cenekSvoboda/14000JKFF/1.0.X_CHYBA.jpg

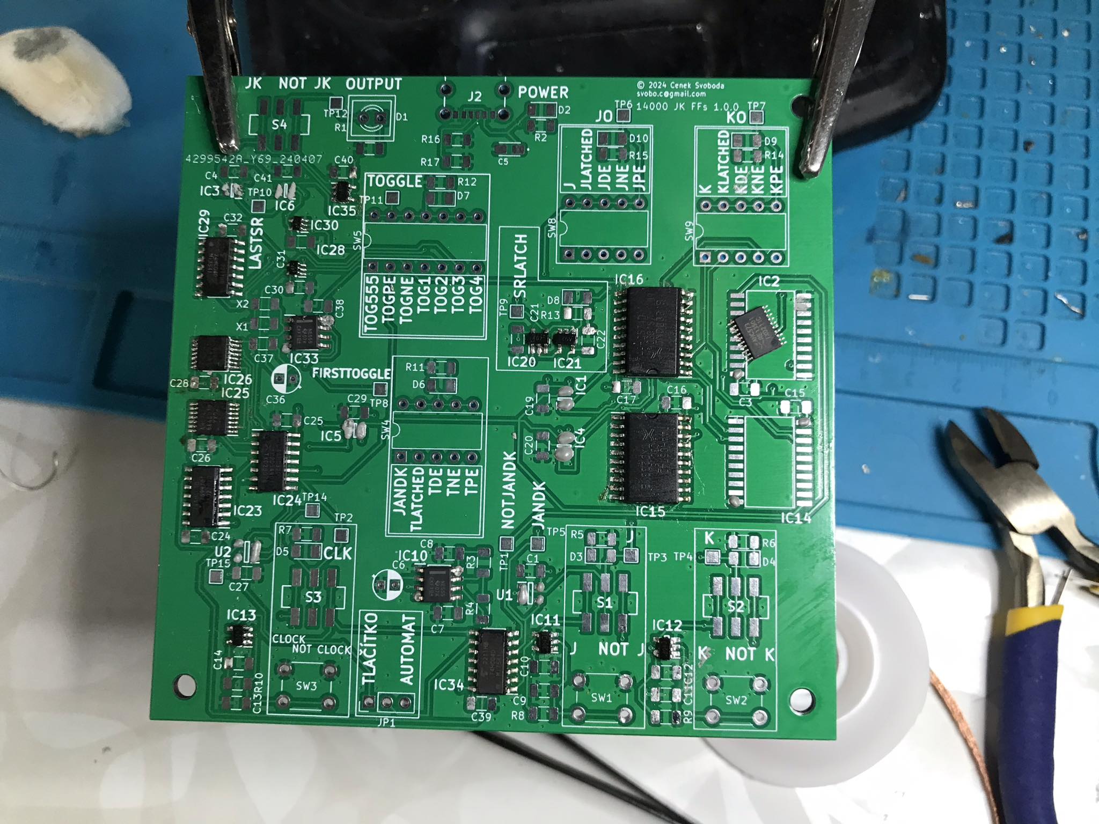
1.0.X_CHYBA.jpg
