cenekSvoboda/14000JKFF/promo1.1.0/7dd303d3-2326-45fb-b104-9f73cf640fcb.jpg

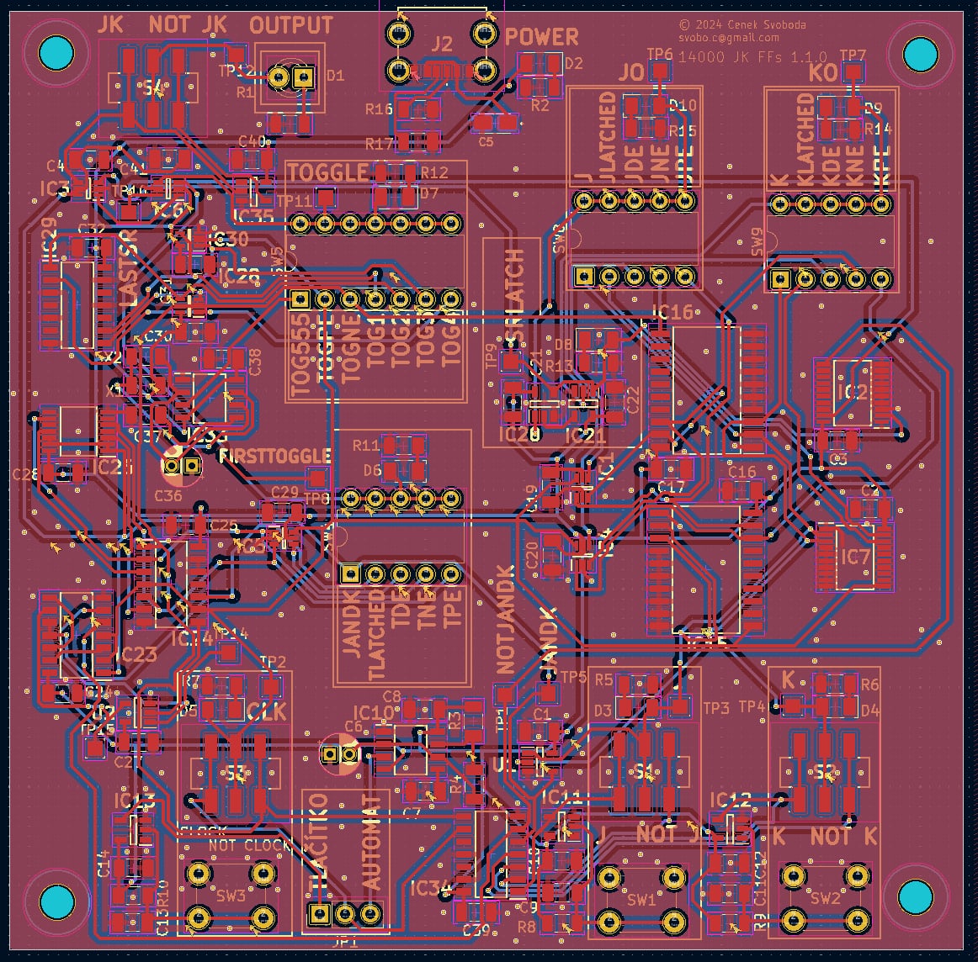
promo1.1.0/7dd303d3-2326-45fb-b104-9f73cf640fcb.jpg
