cenekSvoboda/14000JKFF/1.1.X_CHYBA_B1_B1.jpg

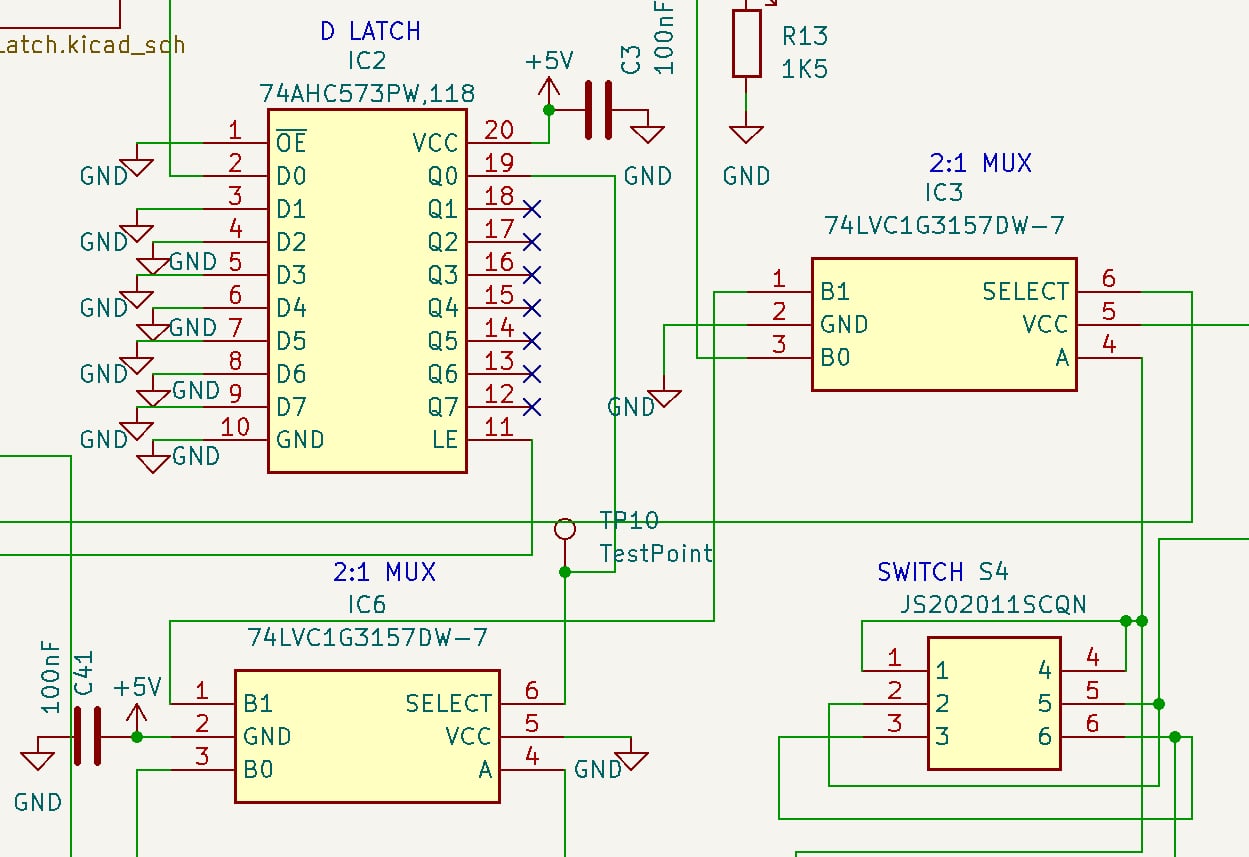
1.1.X_CHYBA_B1_B1.jpg
