cenekSvoboda/14000JKFF/1.2.X_CHYBA_VCCxGND.jpg

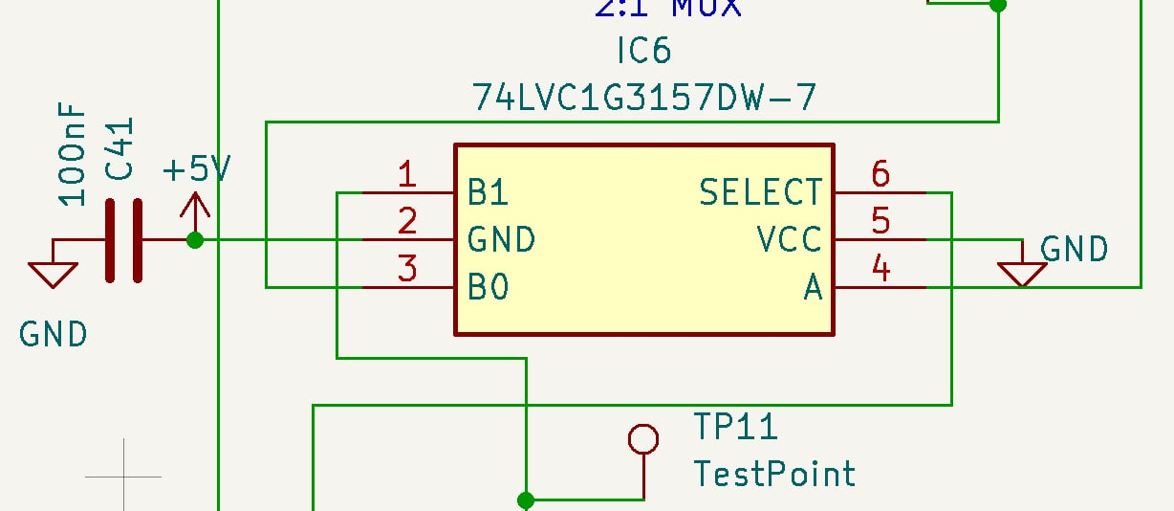
1.2.X_CHYBA_VCCxGND.jpg
