cenekSvoboda/14000JKFF/promo1.1.0/1bc9c821-bae9-479f-b799-7fffa85e23c6.jpg

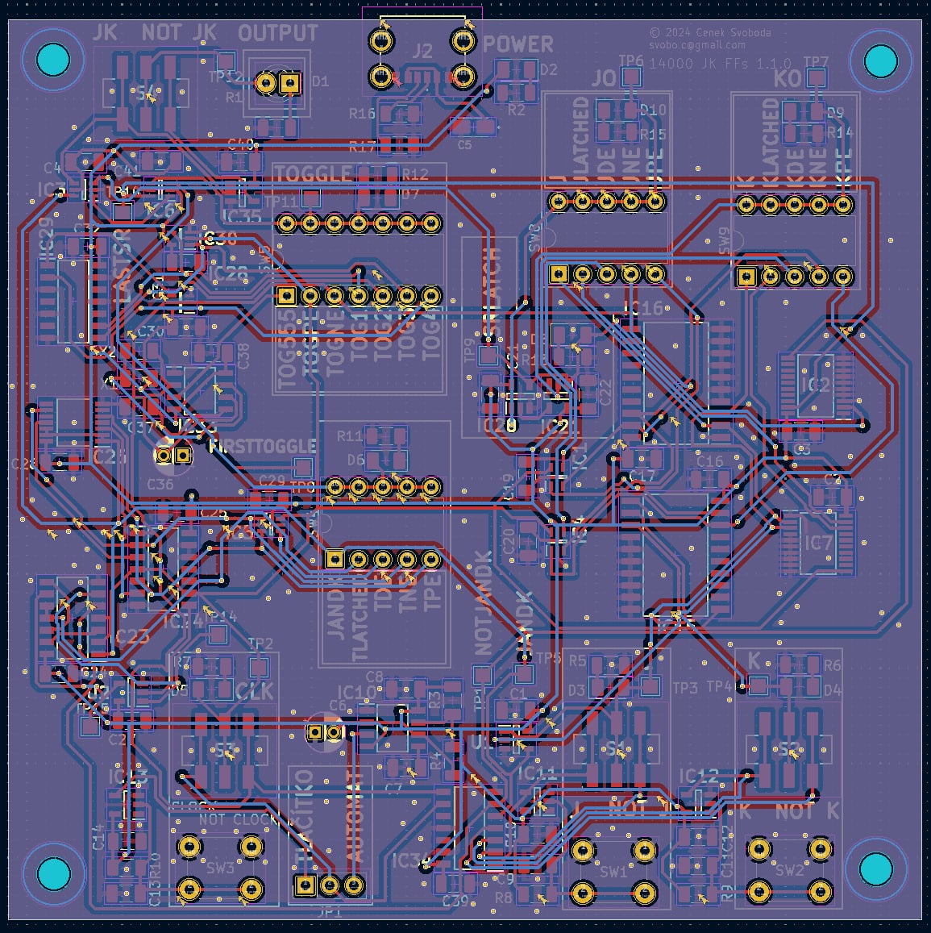
promo1.1.0/1bc9c821-bae9-479f-b799-7fffa85e23c6.jpg
