cenekSvoboda/14000JKFF/promo1.1.0/02855f5d-05ef-4fbc-9375-7c42fc54b73e.jpg

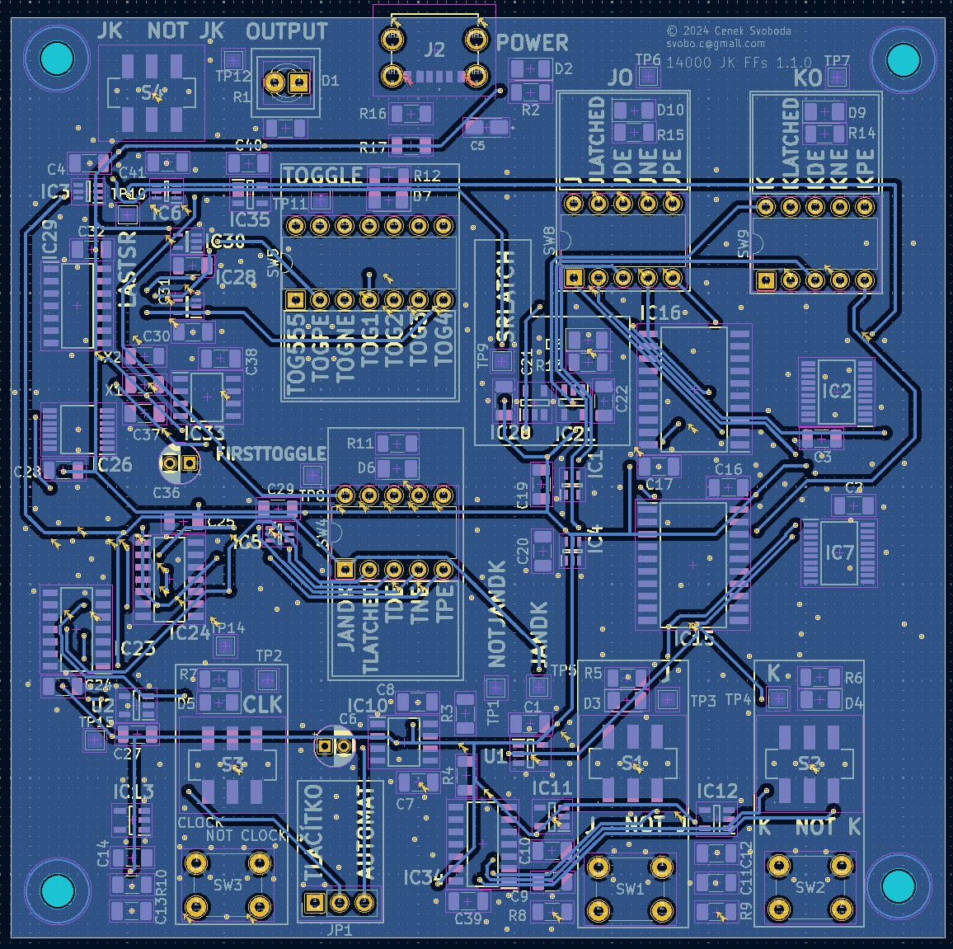
promo1.1.0/02855f5d-05ef-4fbc-9375-7c42fc54b73e.jpg
