cenekSvoboda/14000JKFF/promo1.1.0/92315d0e-d809-469e-a193-0173949fb23d.jpg

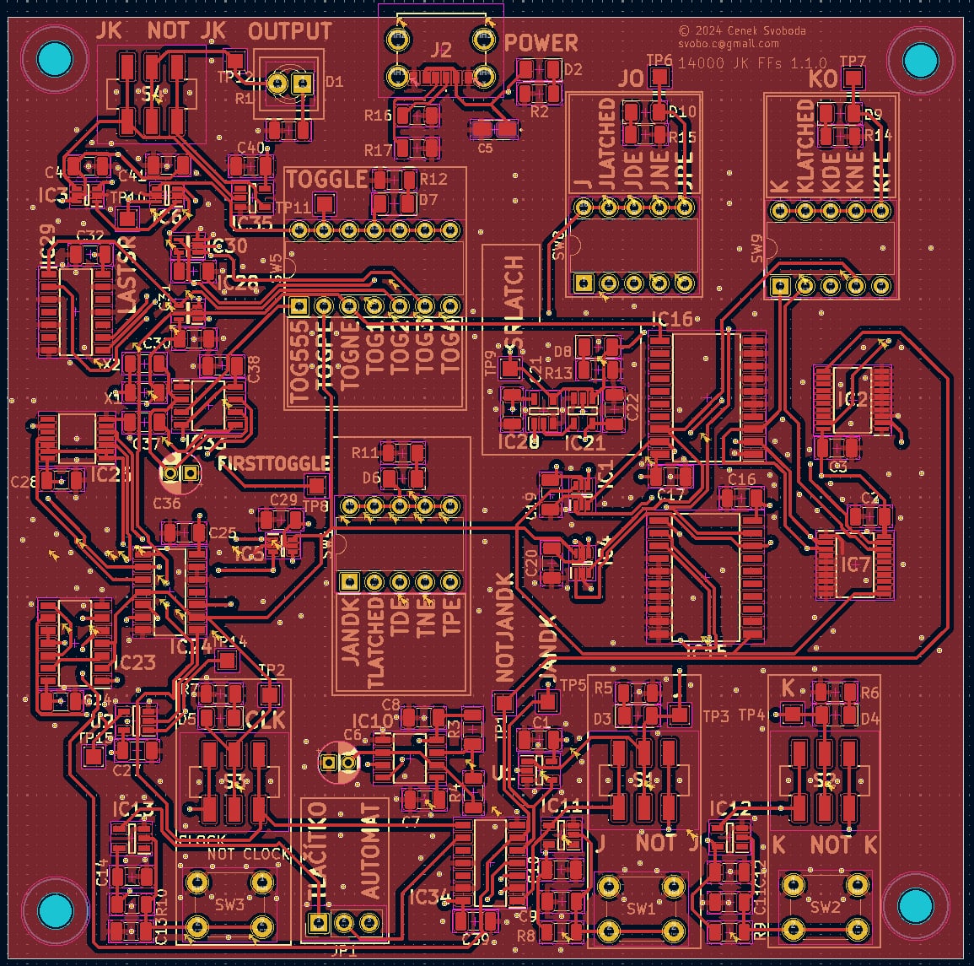
promo1.1.0/92315d0e-d809-469e-a193-0173949fb23d.jpg
