cenekSvoboda/14000JKFF/promo1.1.0/434751873_1422562068364680_6383948071379897390_n.png

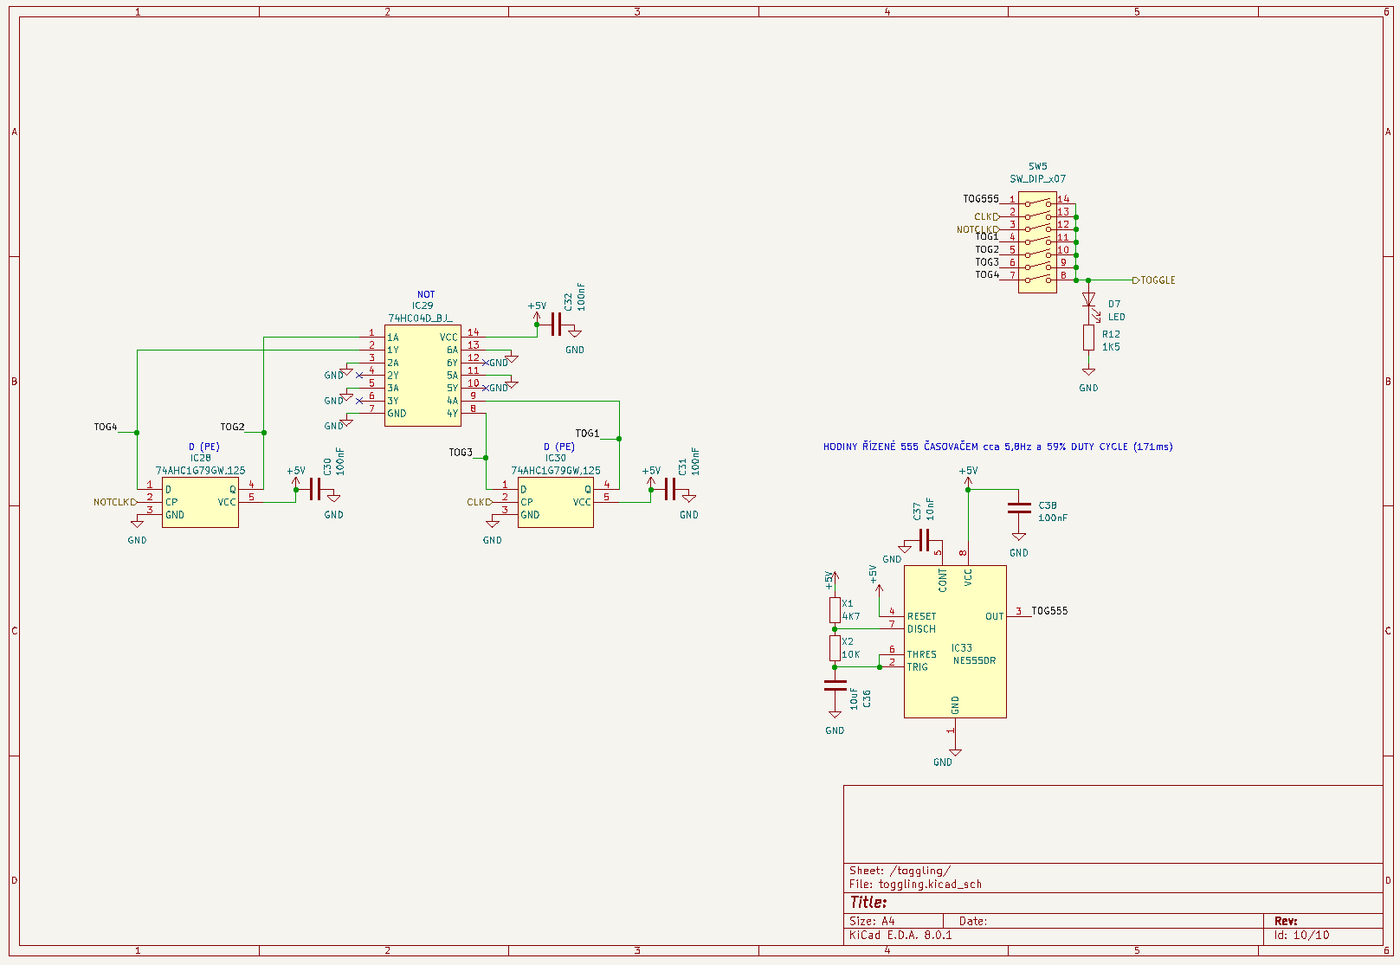
promo1.1.0/434751873_1422562068364680_6383948071379897390_n.png
