cenekSvoboda/14000JKFF/promo1.1.0/434948359_1613031582778598_4506938251706443134_n.png

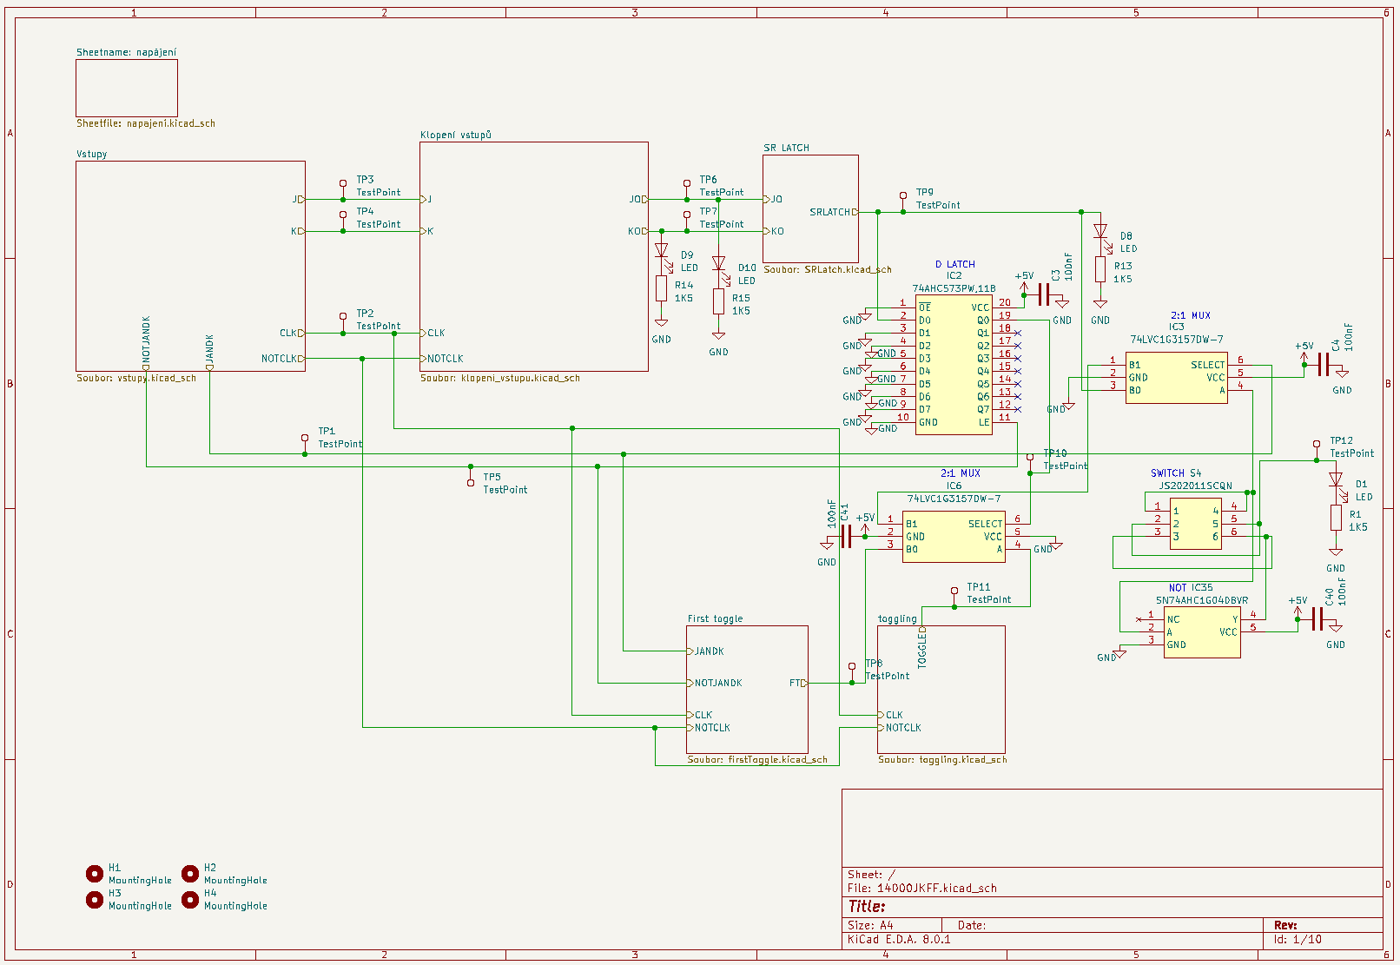
promo1.1.0/434948359_1613031582778598_4506938251706443134_n.png
