cenekSvoboda/14000JKFF/promo1.1.0/435037000_763792102628698_8692262415894147883_n.png

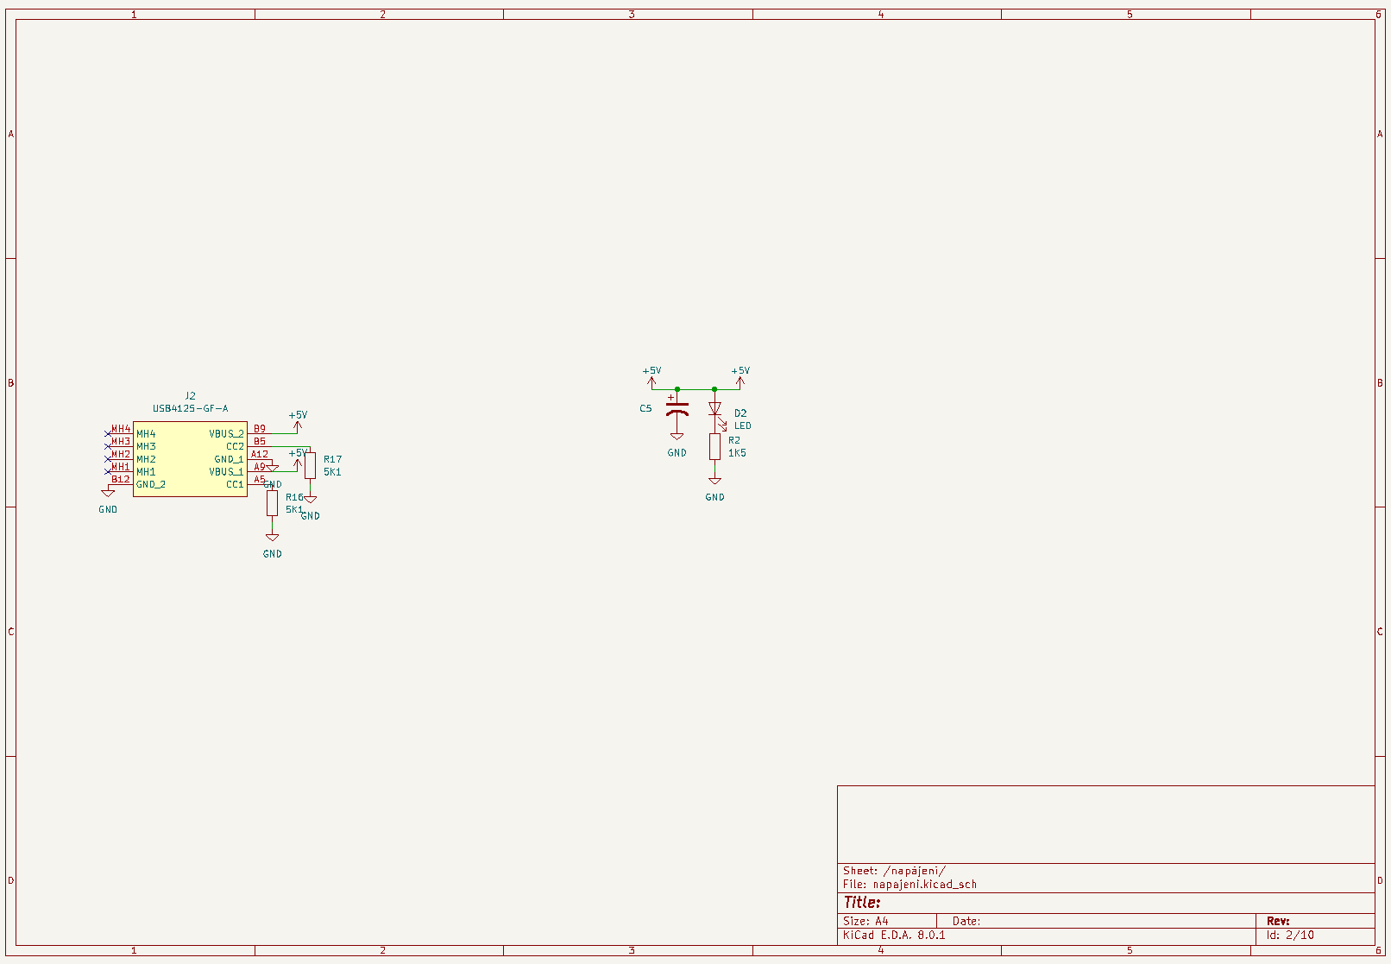
promo1.1.0/435037000_763792102628698_8692262415894147883_n.png
