cenekSvoboda/14000JKFF/promo1.1.0/435190713_1480352395887250_4431496618582273658_n.png

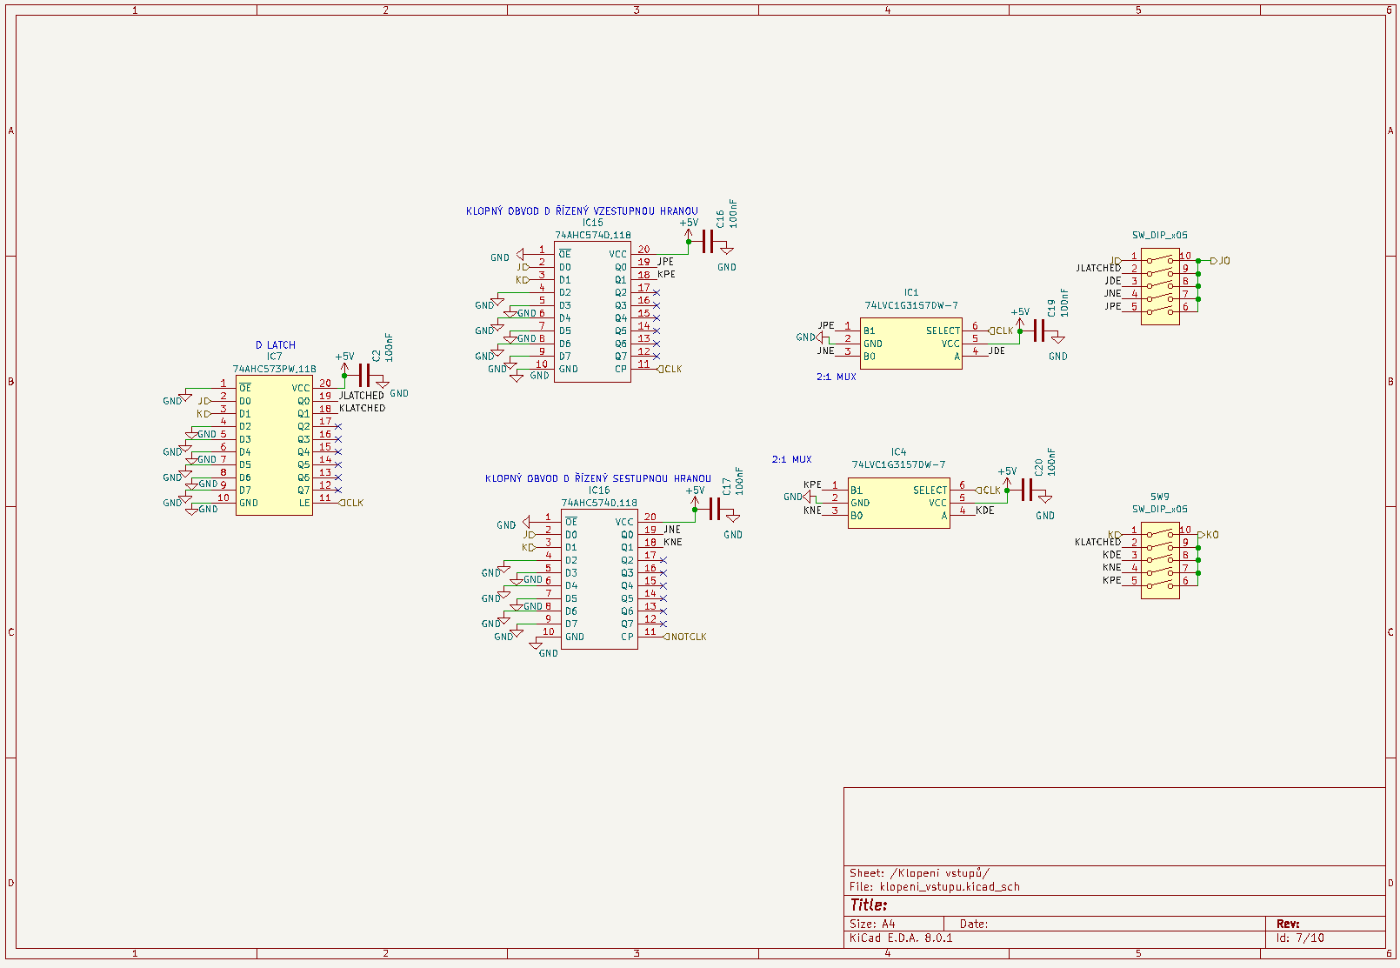
promo1.1.0/435190713_1480352395887250_4431496618582273658_n.png
