cenekSvoboda/14000JKFF/promo1.1.0/435190714_416963137751240_3876868407123877802_n.png

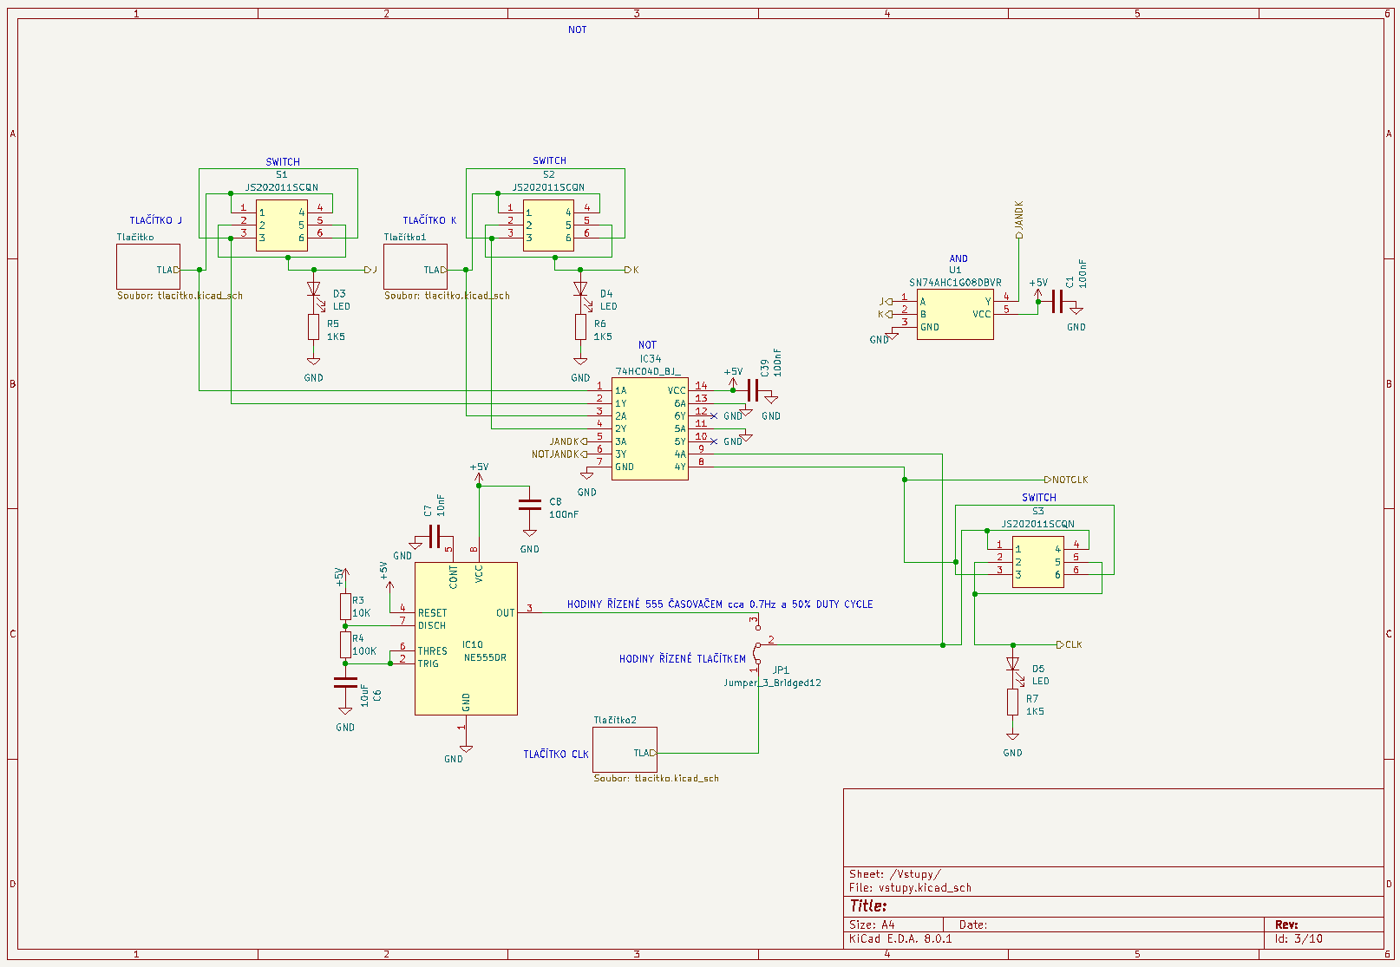
promo1.1.0/435190714_416963137751240_3876868407123877802_n.png
