cenekSvoboda/14000JKFF/promo1.1.0/435260007_739919748125636_3808664859414099818_n.png

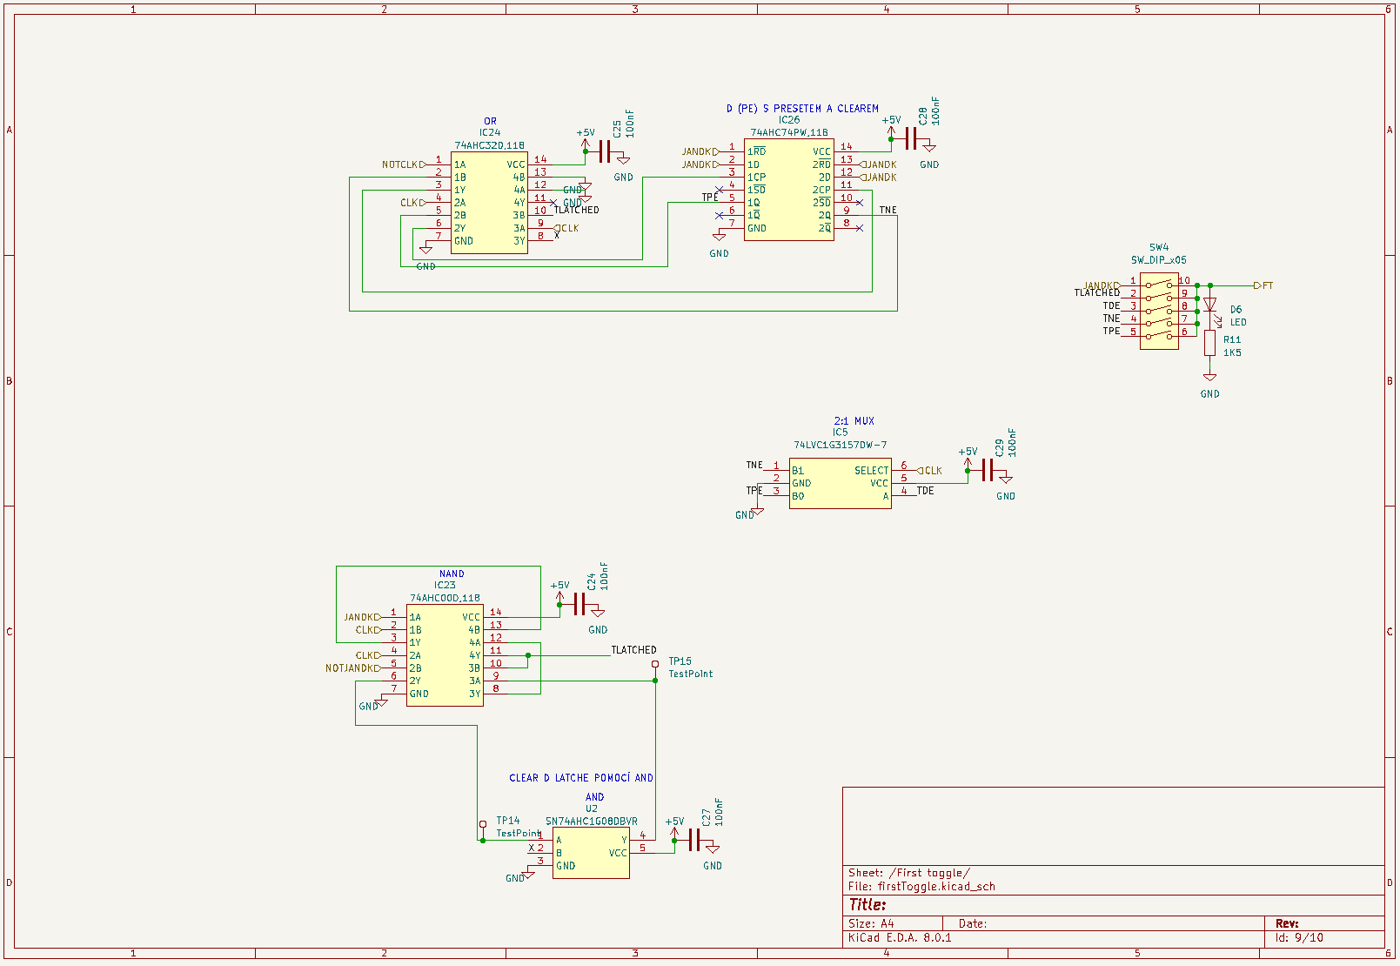
promo1.1.0/435260007_739919748125636_3808664859414099818_n.png
