cenekSvoboda/14000JKFF/promo1.1.0/437082656_329488143485524_8711874063106302236_n.png

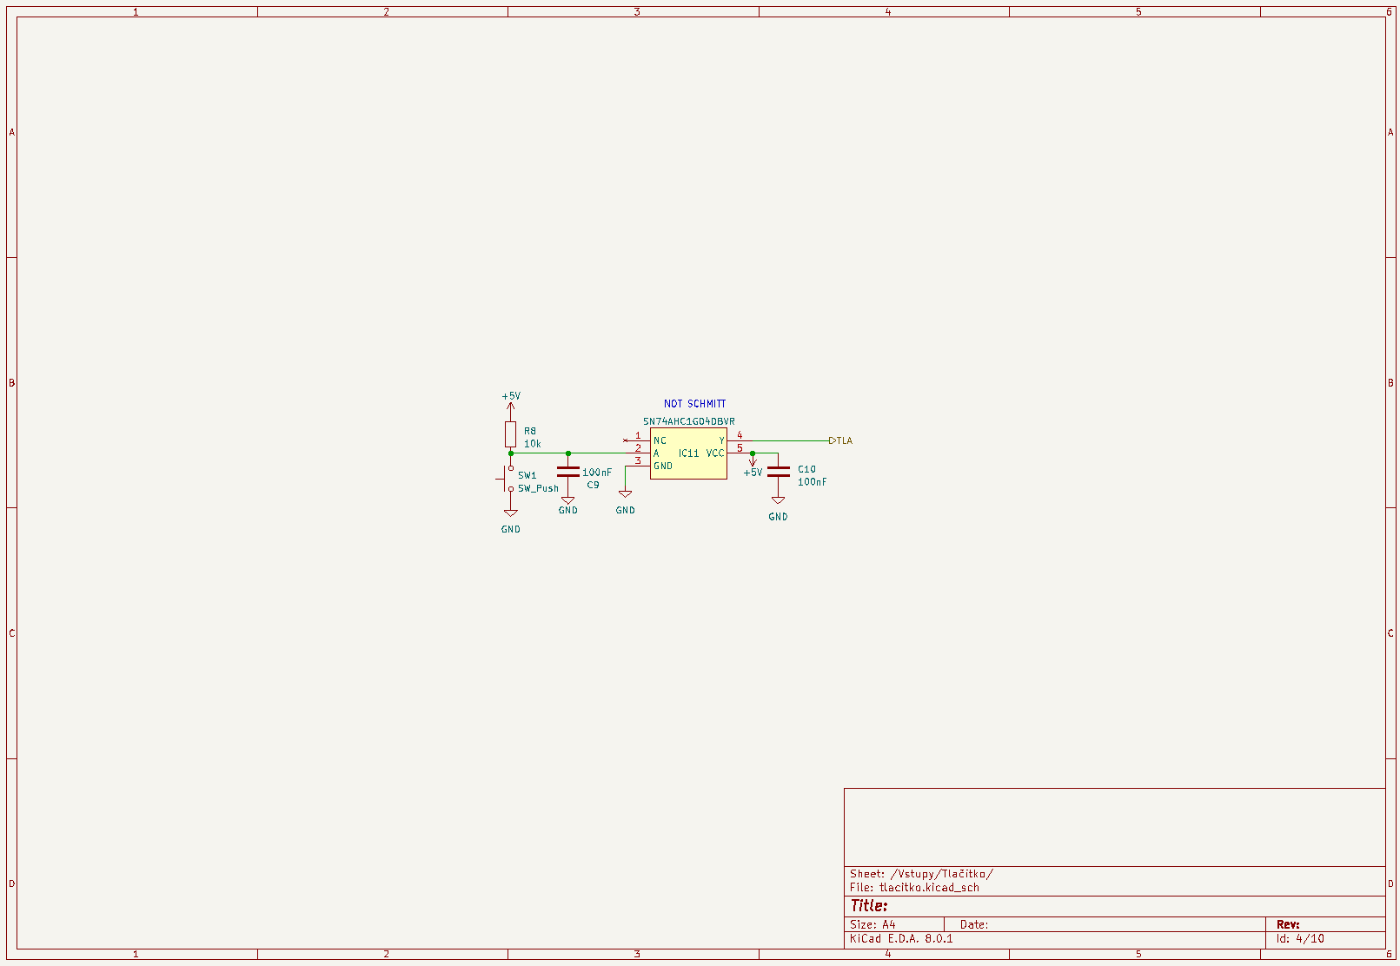
promo1.1.0/437082656_329488143485524_8711874063106302236_n.png
