cenekSvoboda/14000JKFF/promo1.1.0/437264382_1151271189196162_3127060908040445435_n.png

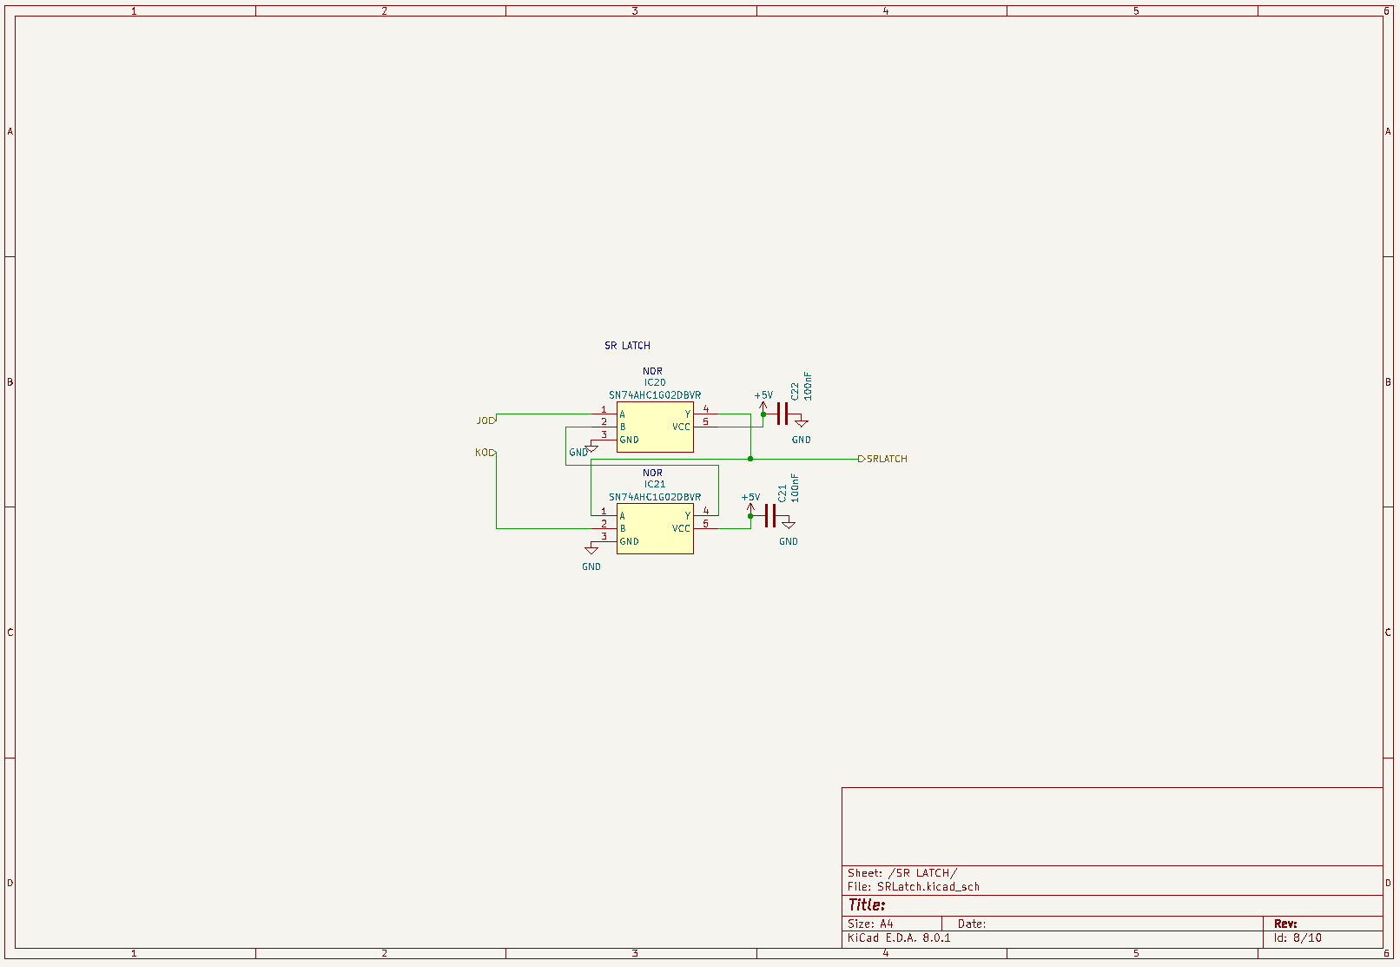
promo1.1.0/437264382_1151271189196162_3127060908040445435_n.png
