cenekSvoboda/14000JKFF/promo1.1.0/ea9c4601-4ea4-451e-9b5b-cdc2b412200c.jpg

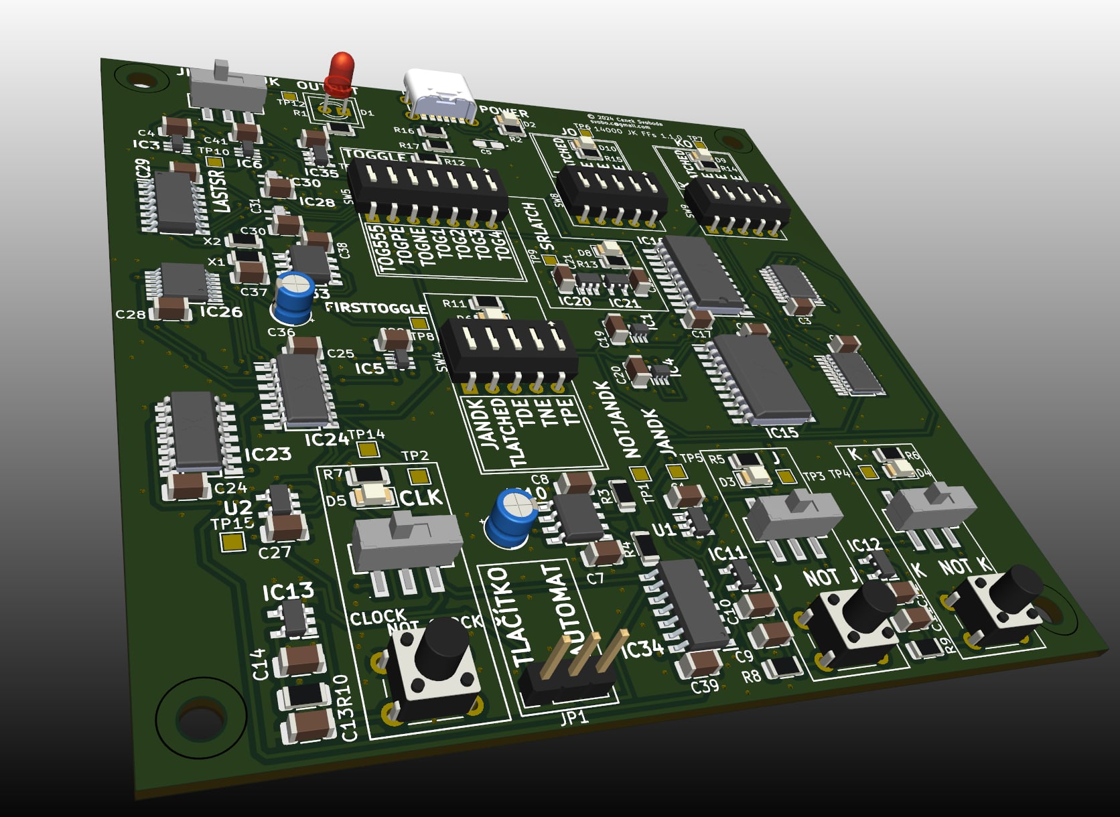
promo1.1.0/ea9c4601-4ea4-451e-9b5b-cdc2b412200c.jpg
