cenekSvoboda/14000JKFF/promo1.2.0/435222782_2579388365554020_5775244540496883172_n.png

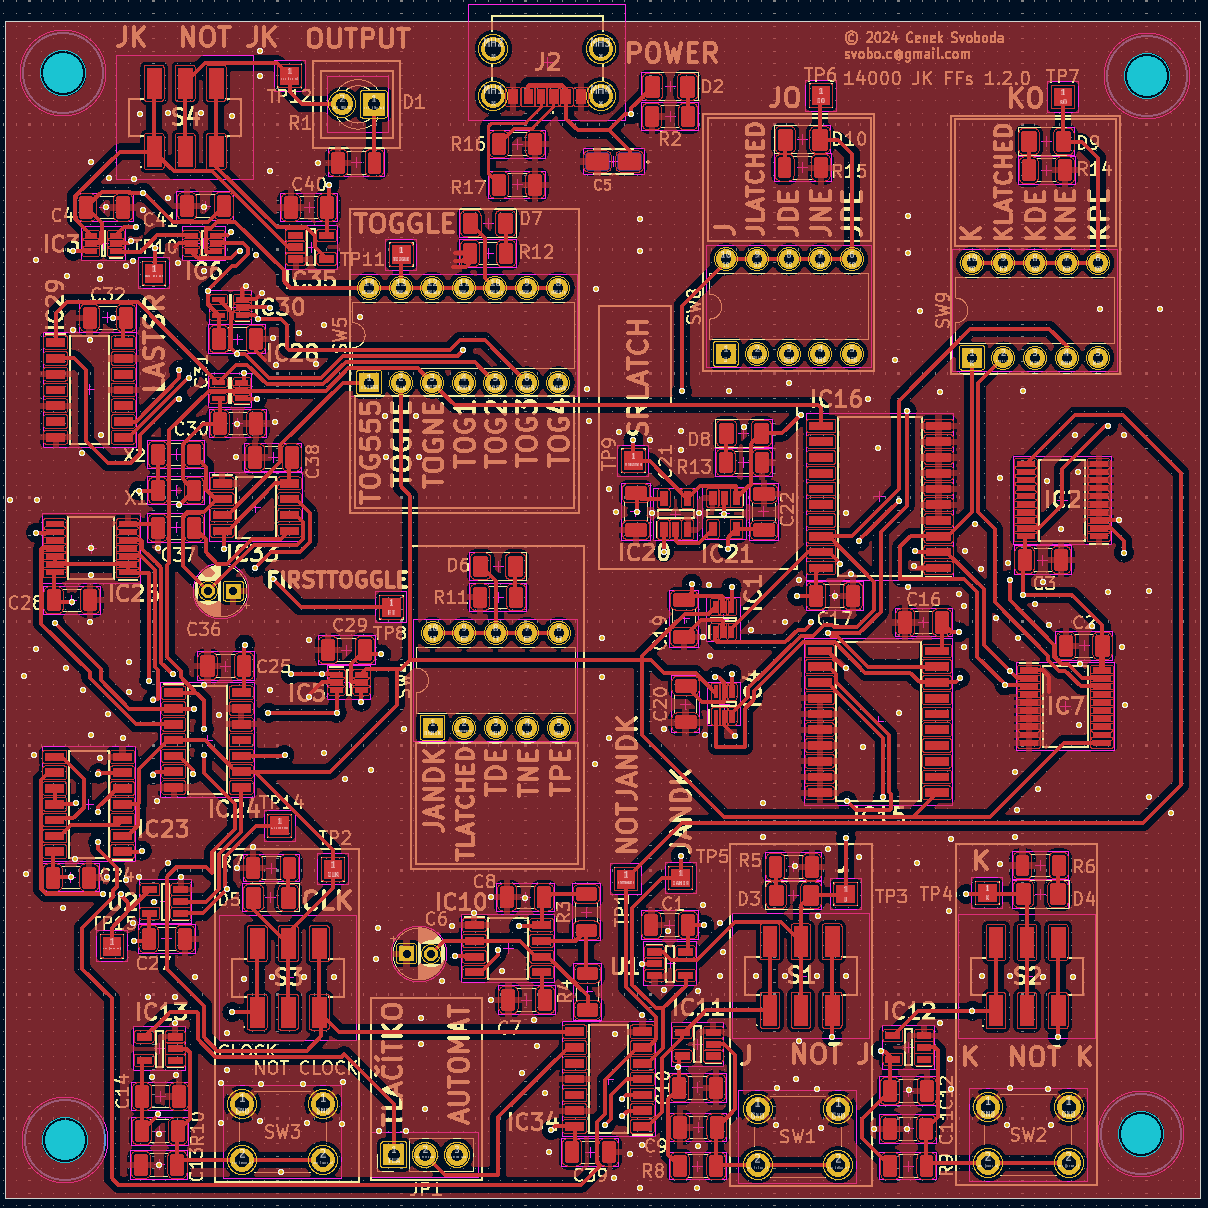
promo1.2.0/435222782_2579388365554020_5775244540496883172_n.png
