cenekSvoboda/14000JKFF/promo1.2.0/435315866_8142650485749660_6406764504713918341_n.png

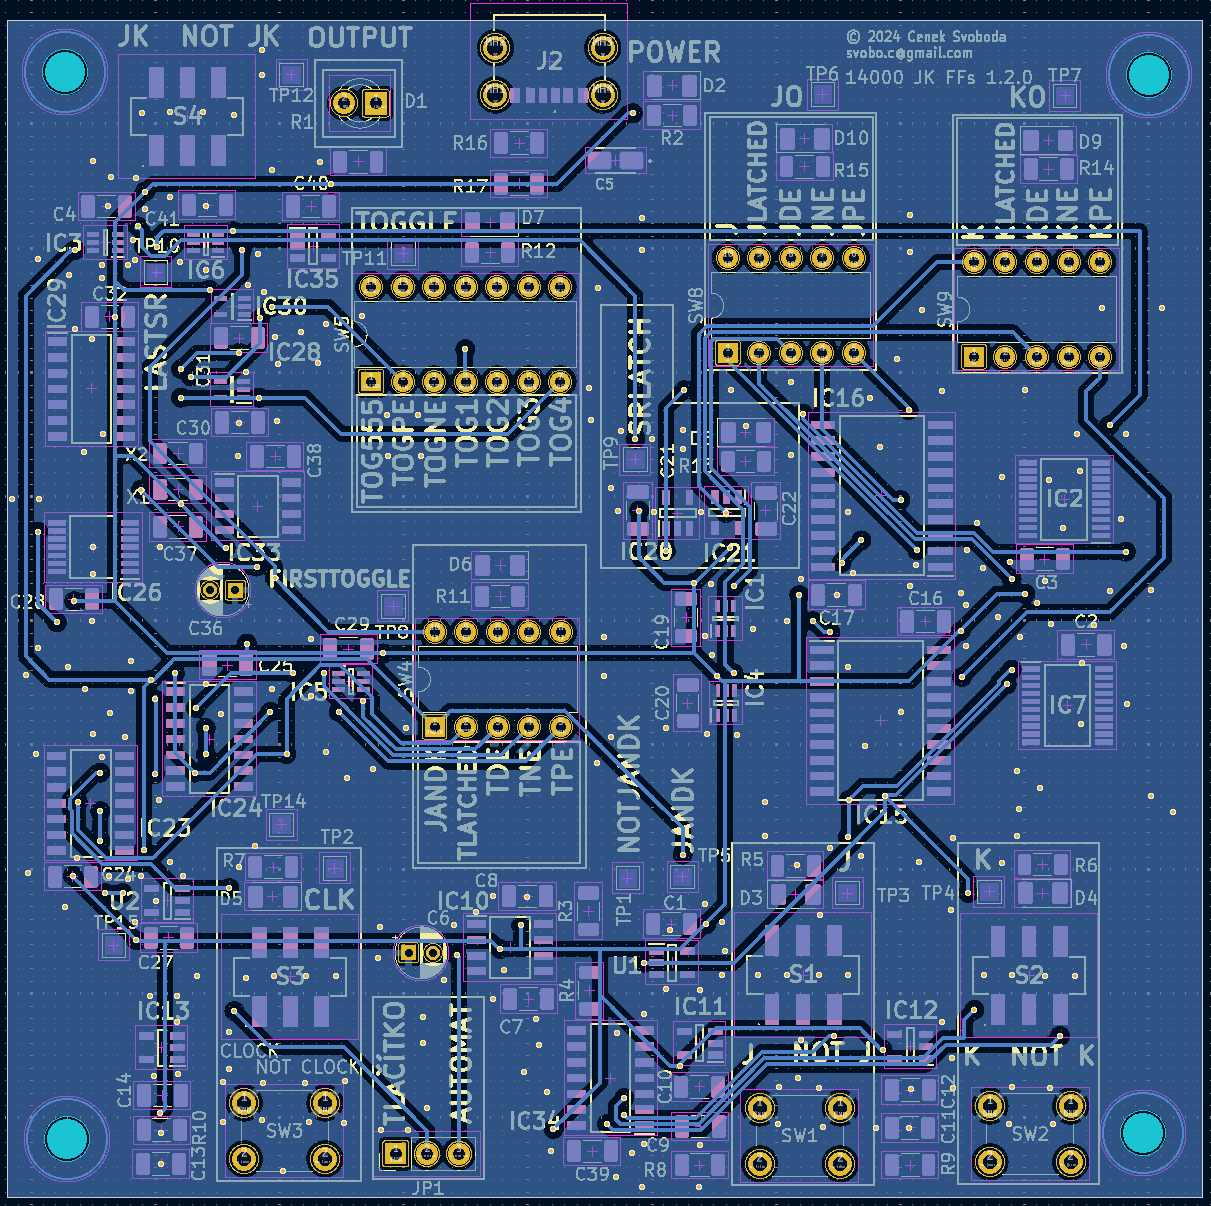
promo1.2.0/435315866_8142650485749660_6406764504713918341_n.png
