cenekSvoboda/14000JKFF/promo1.2.0/435317457_471226671969940_7390329915188303071_n.png

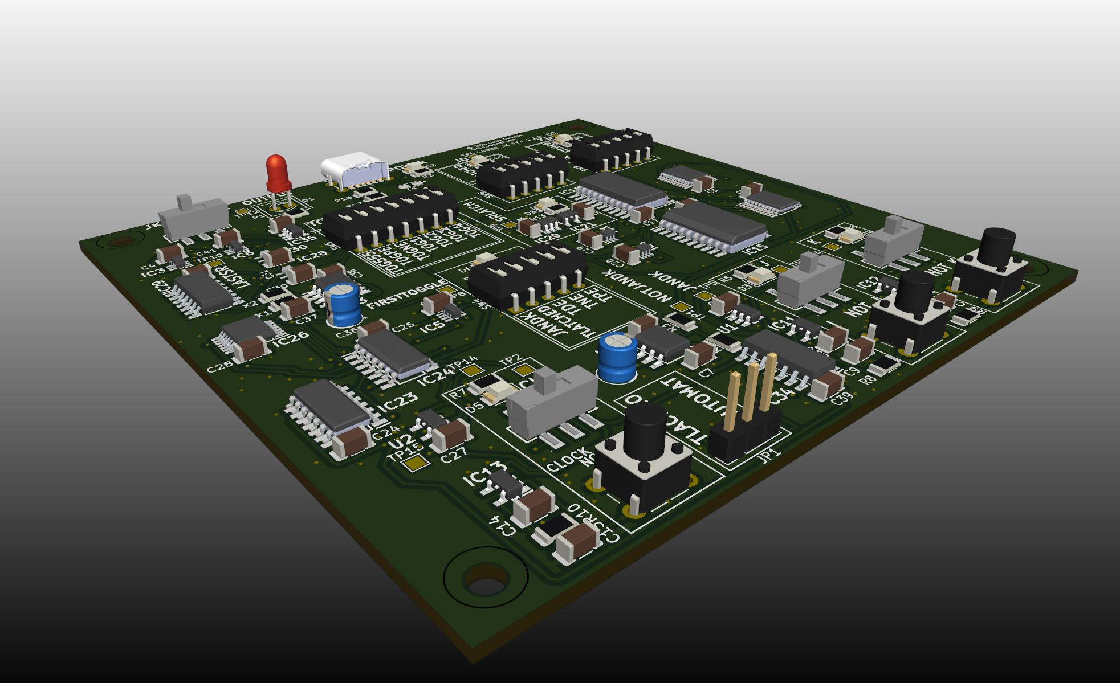
promo1.2.0/435317457_471226671969940_7390329915188303071_n.png
