cenekSvoboda/14000JKFF/promo1.2.0/437094882_348612927769522_7042759841677619268_n.png

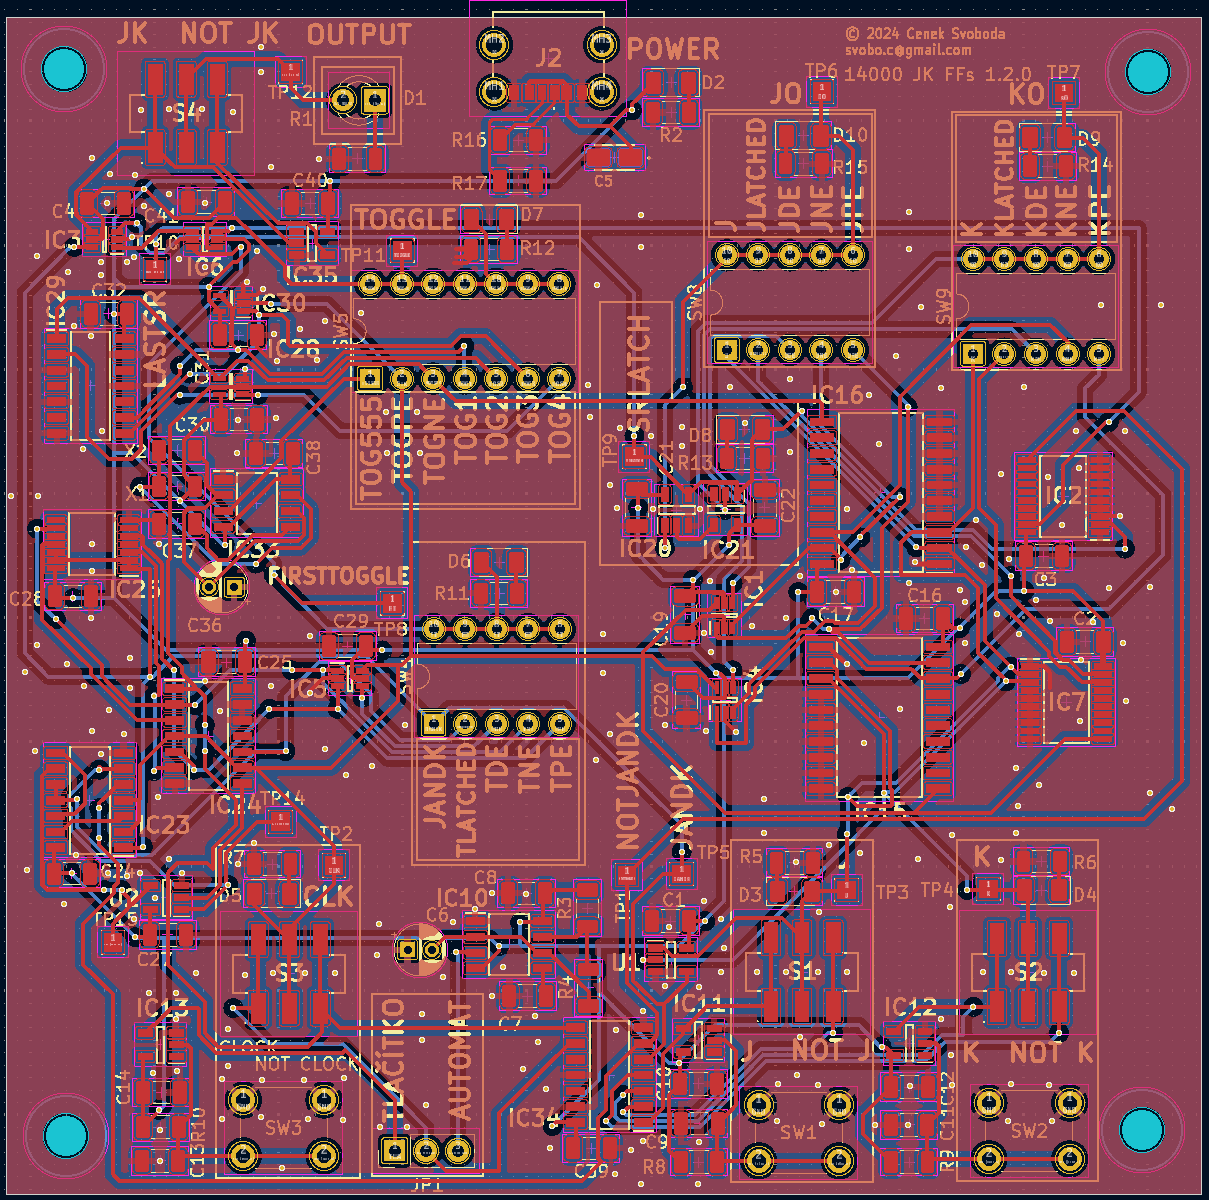
promo1.2.0/437094882_348612927769522_7042759841677619268_n.png
