cenekSvoboda/14000JKFF/promo1.2.0/437178916_459456486742328_1998249071662413026_n.png

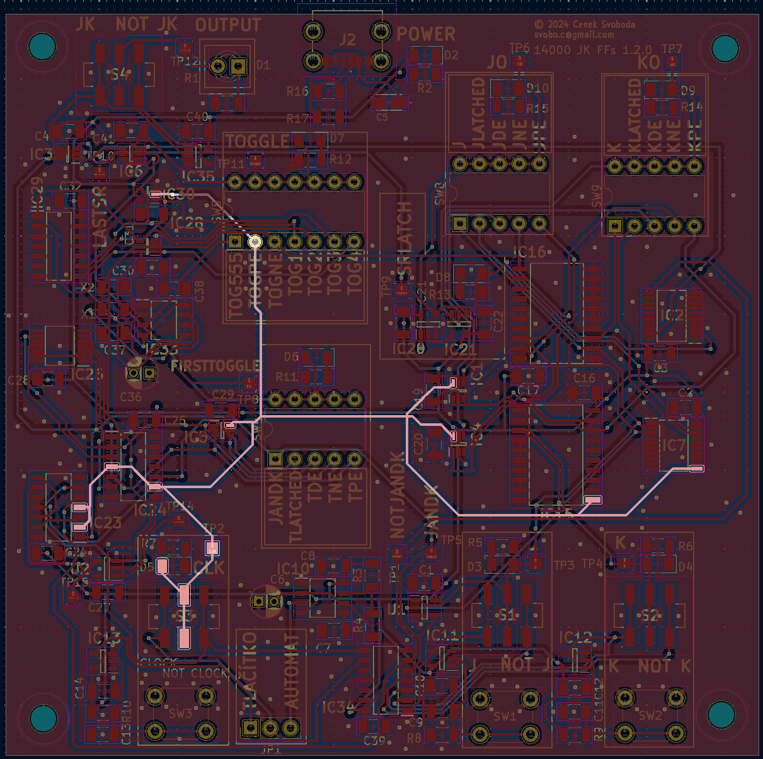
promo1.2.0/437178916_459456486742328_1998249071662413026_n.png
