cenekSvoboda/14000JKFF/promo1.2.0/437182039_449787654098766_6627805781177508900_n.png

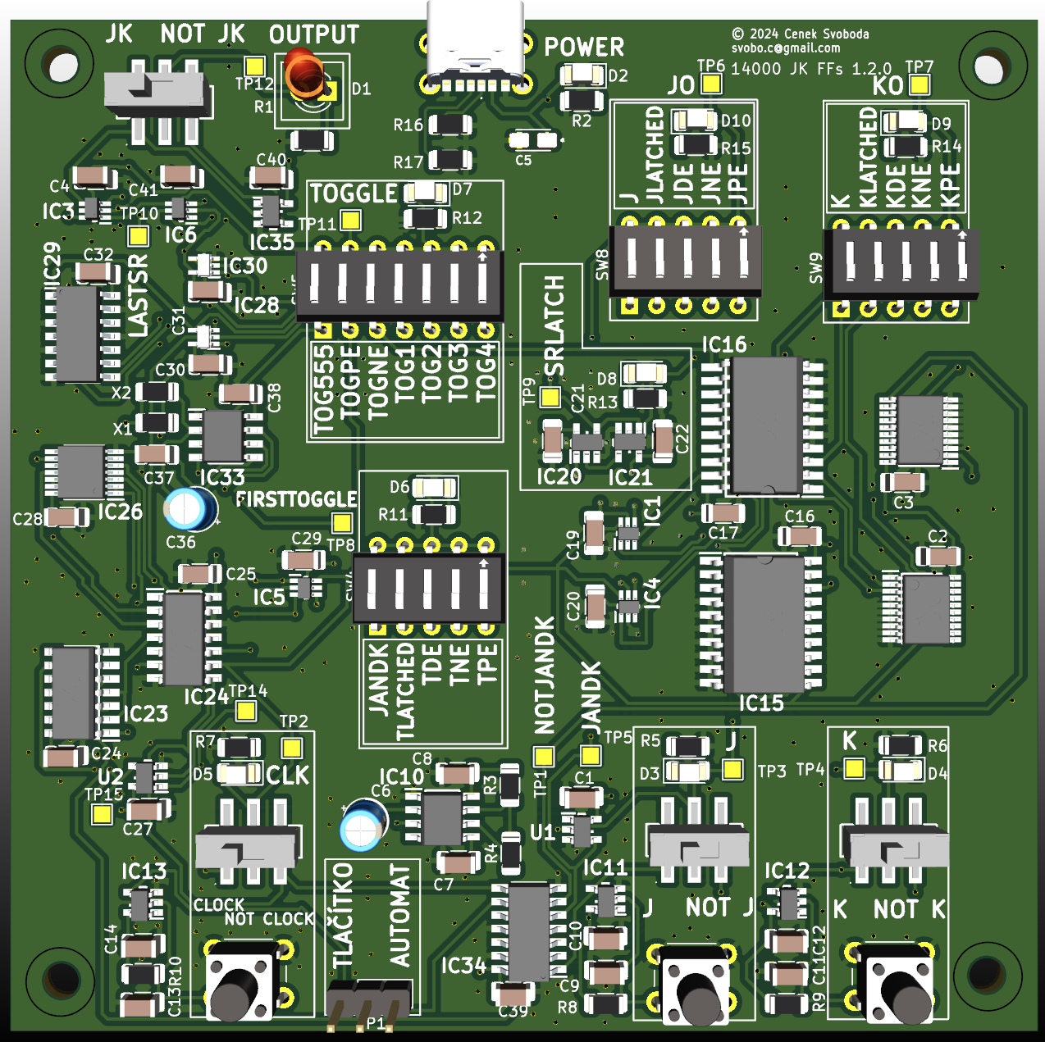
promo1.2.0/437182039_449787654098766_6627805781177508900_n.png
