cenekSvoboda/14000JKFF/promo1.2.0/440308909_959988672387661_6118440905810270759_n.png

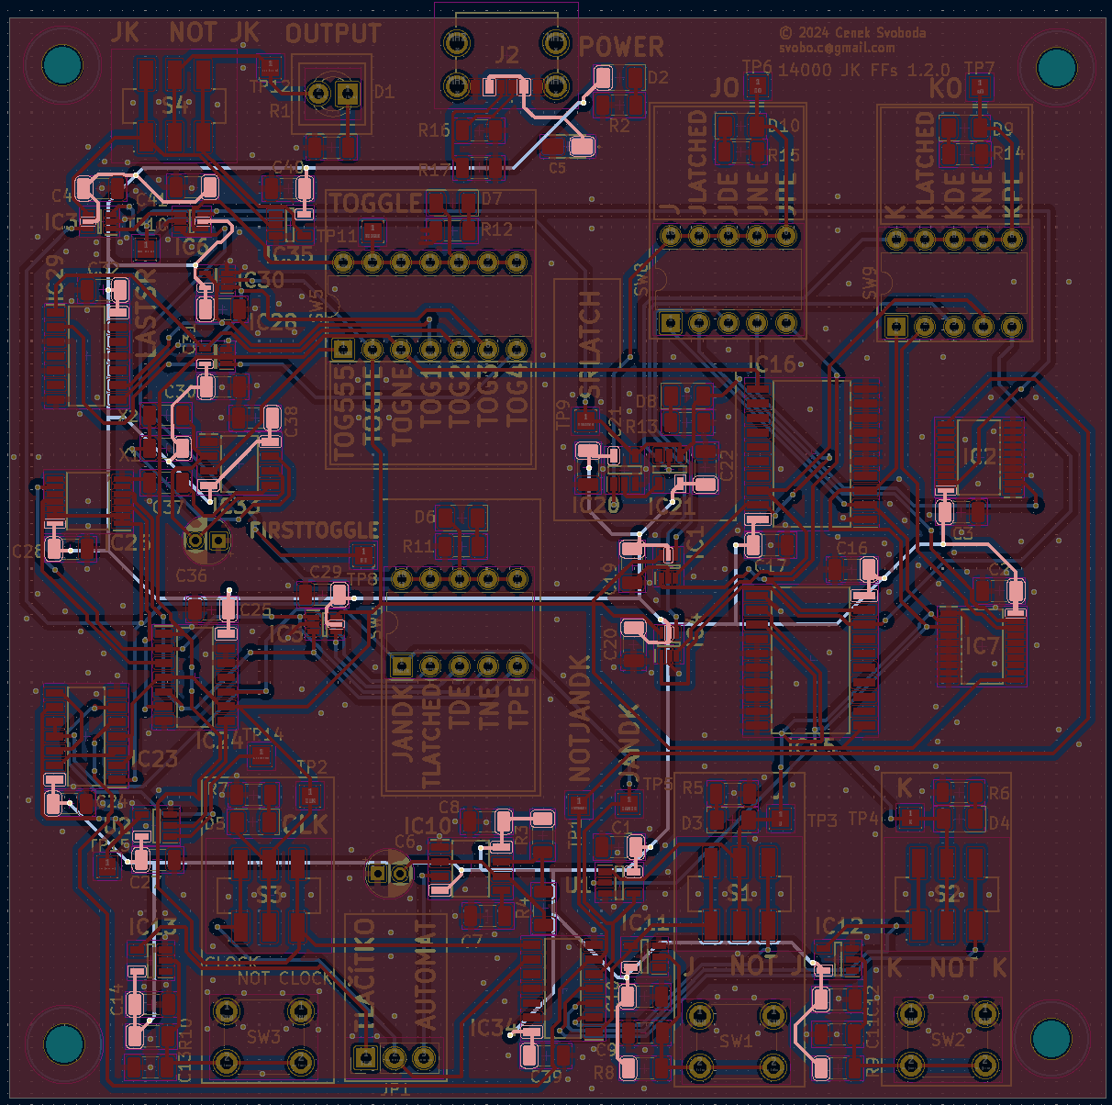
promo1.2.0/440308909_959988672387661_6118440905810270759_n.png
