cenekSvoboda/14000JKFF/promo1.3.0/440322806_737700945238231_4989698711130704953_n.png

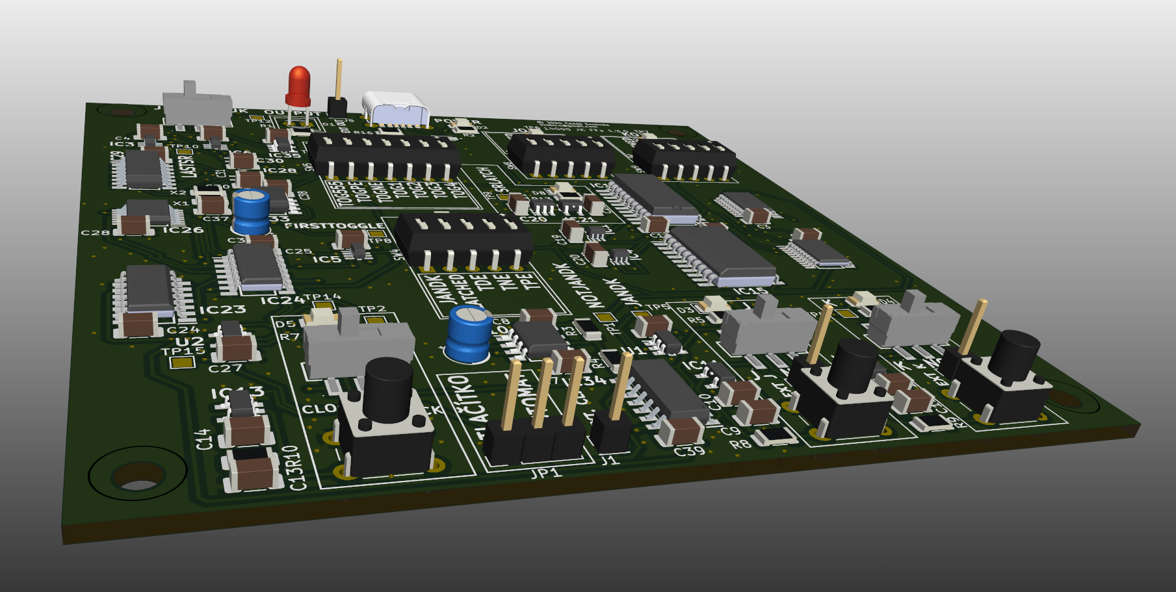
promo1.3.0/440322806_737700945238231_4989698711130704953_n.png
