cenekSvoboda/14000JKFF/promo1.3.0/440425796_473161125053435_3475694870257111084_n.png

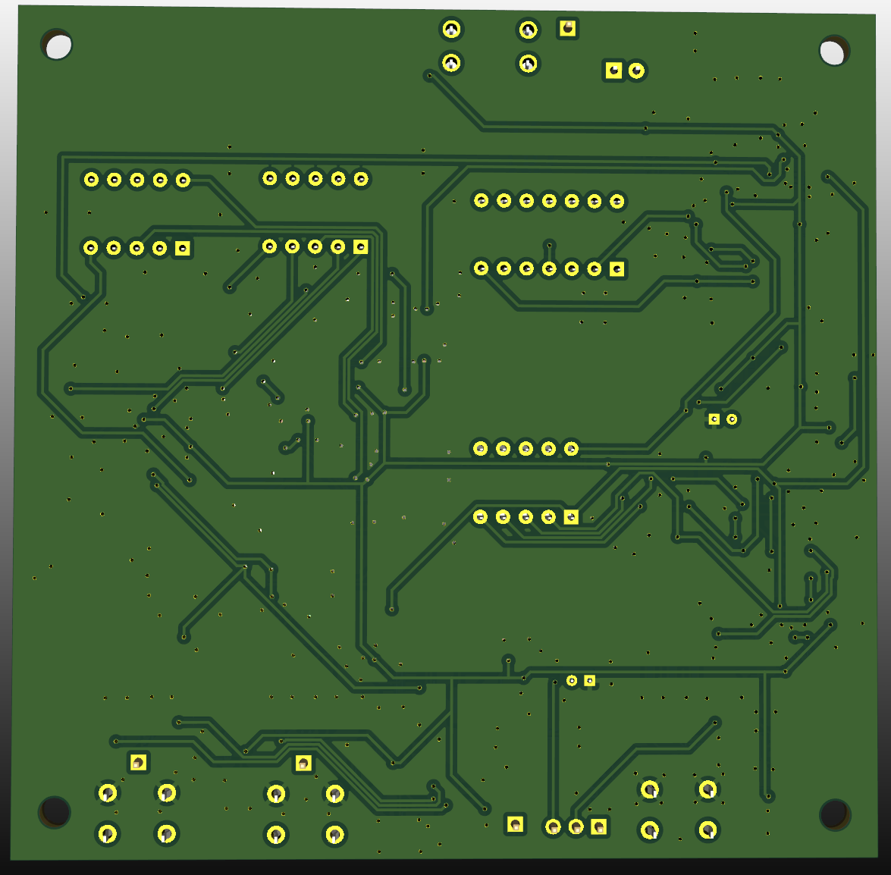
promo1.3.0/440425796_473161125053435_3475694870257111084_n.png
