cenekSvoboda/14000JKFF/promo1.3.0/440479695_1001469108207574_3616758496767621077_n.png

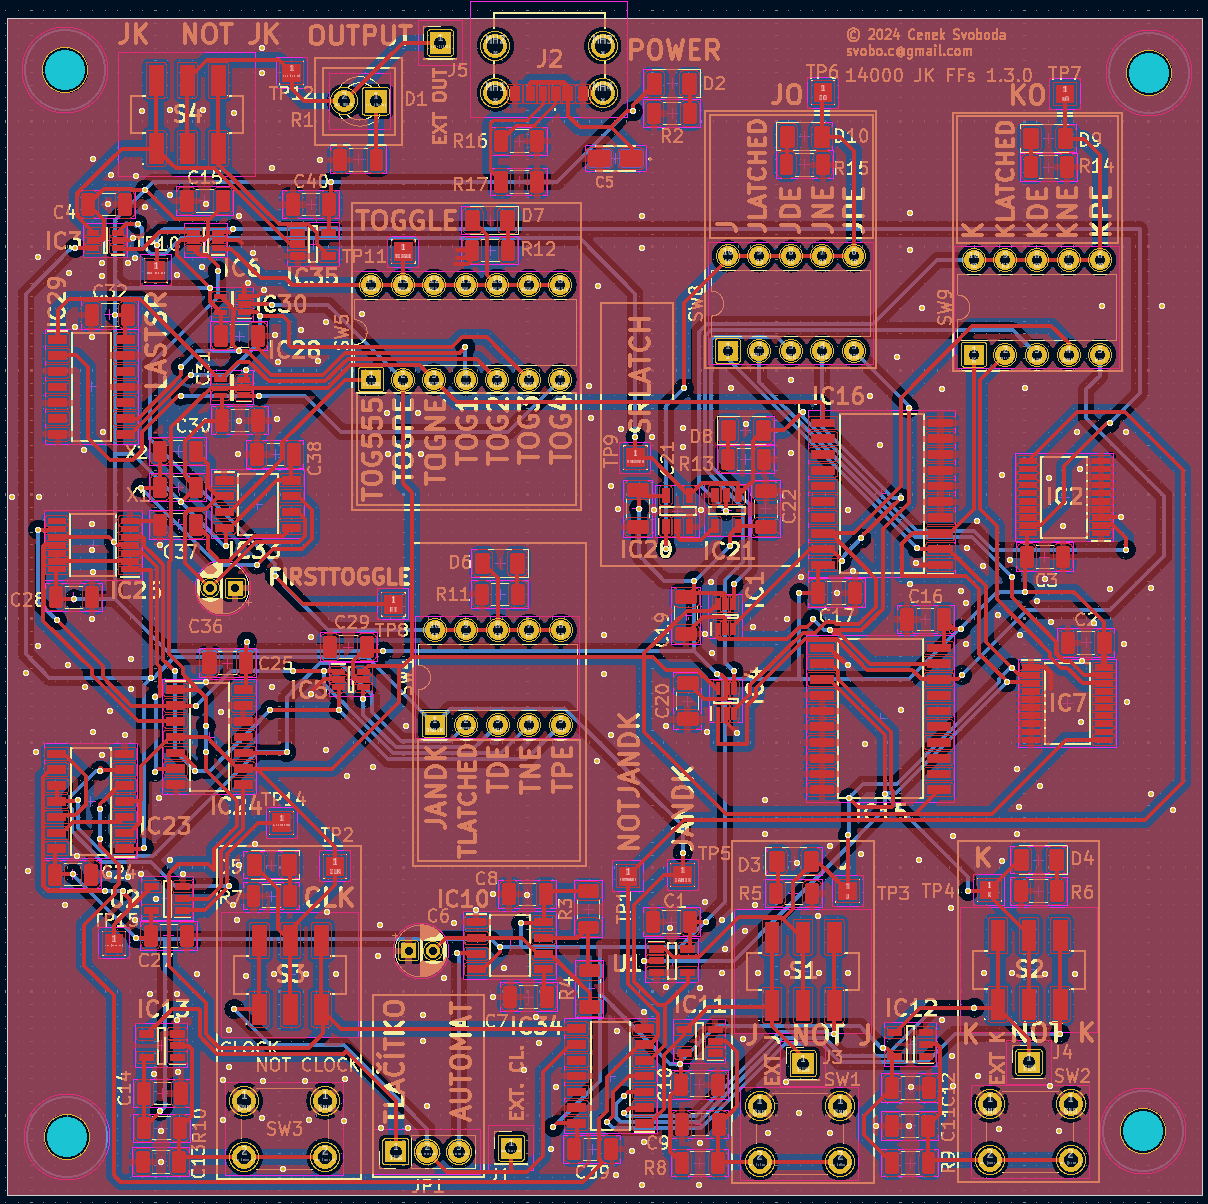
promo1.3.0/440479695_1001469108207574_3616758496767621077_n.png
