cenekSvoboda/14000JKFF/promo1.3.0/440523839_1975976369503368_6072457625410557961_n.png

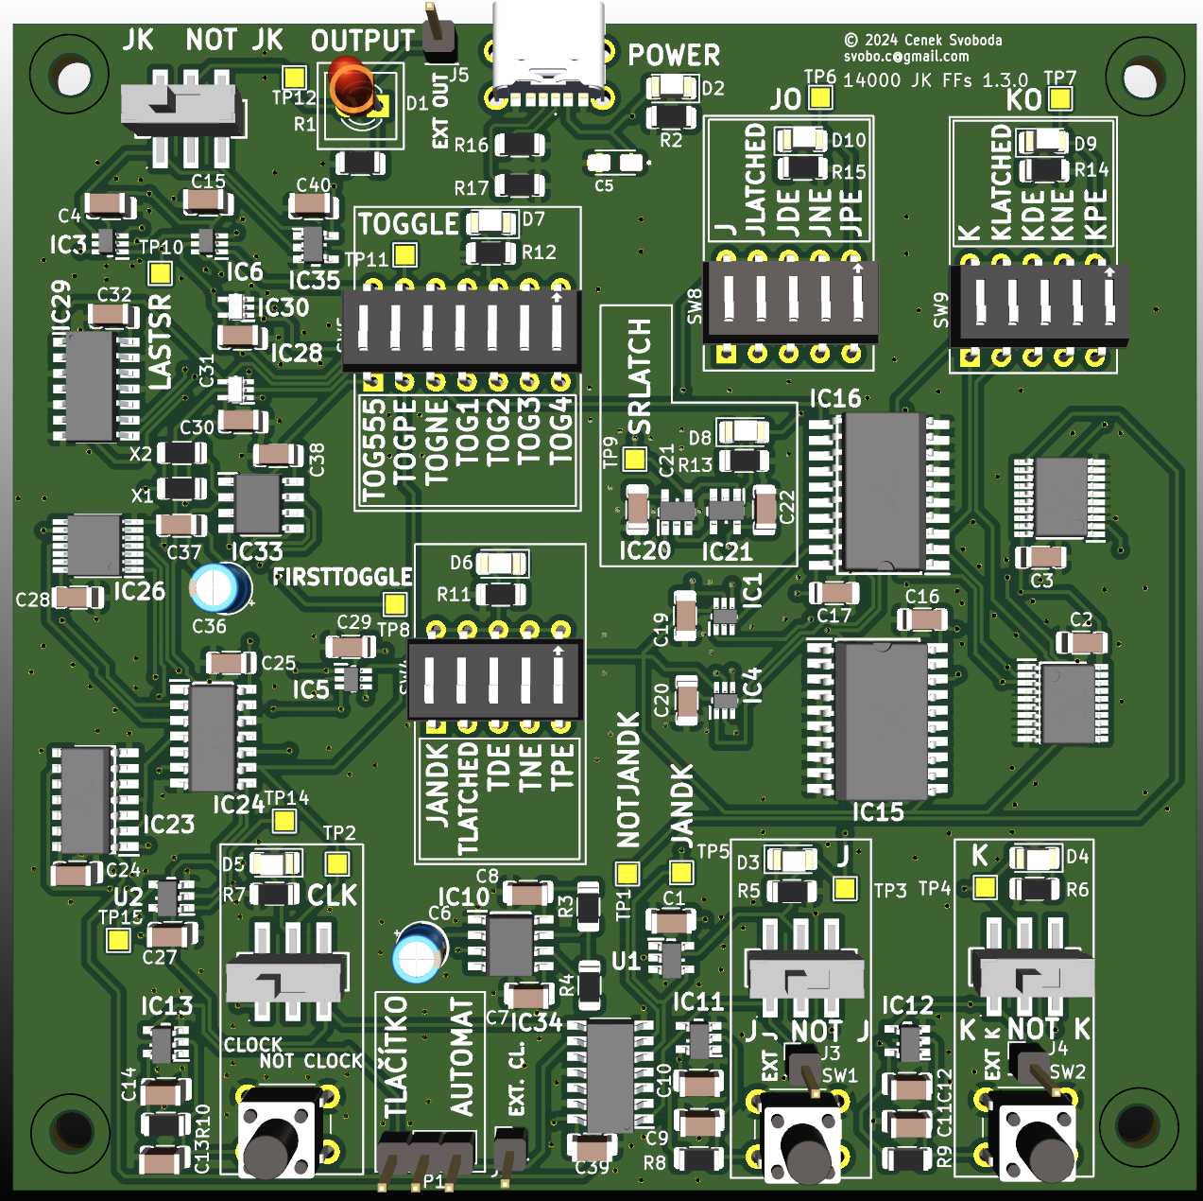
promo1.3.0/440523839_1975976369503368_6072457625410557961_n.png
