cenekSvoboda/14000JKFF/promo1.3.0/440539407_1648068675965915_7974691574529142560_n.png

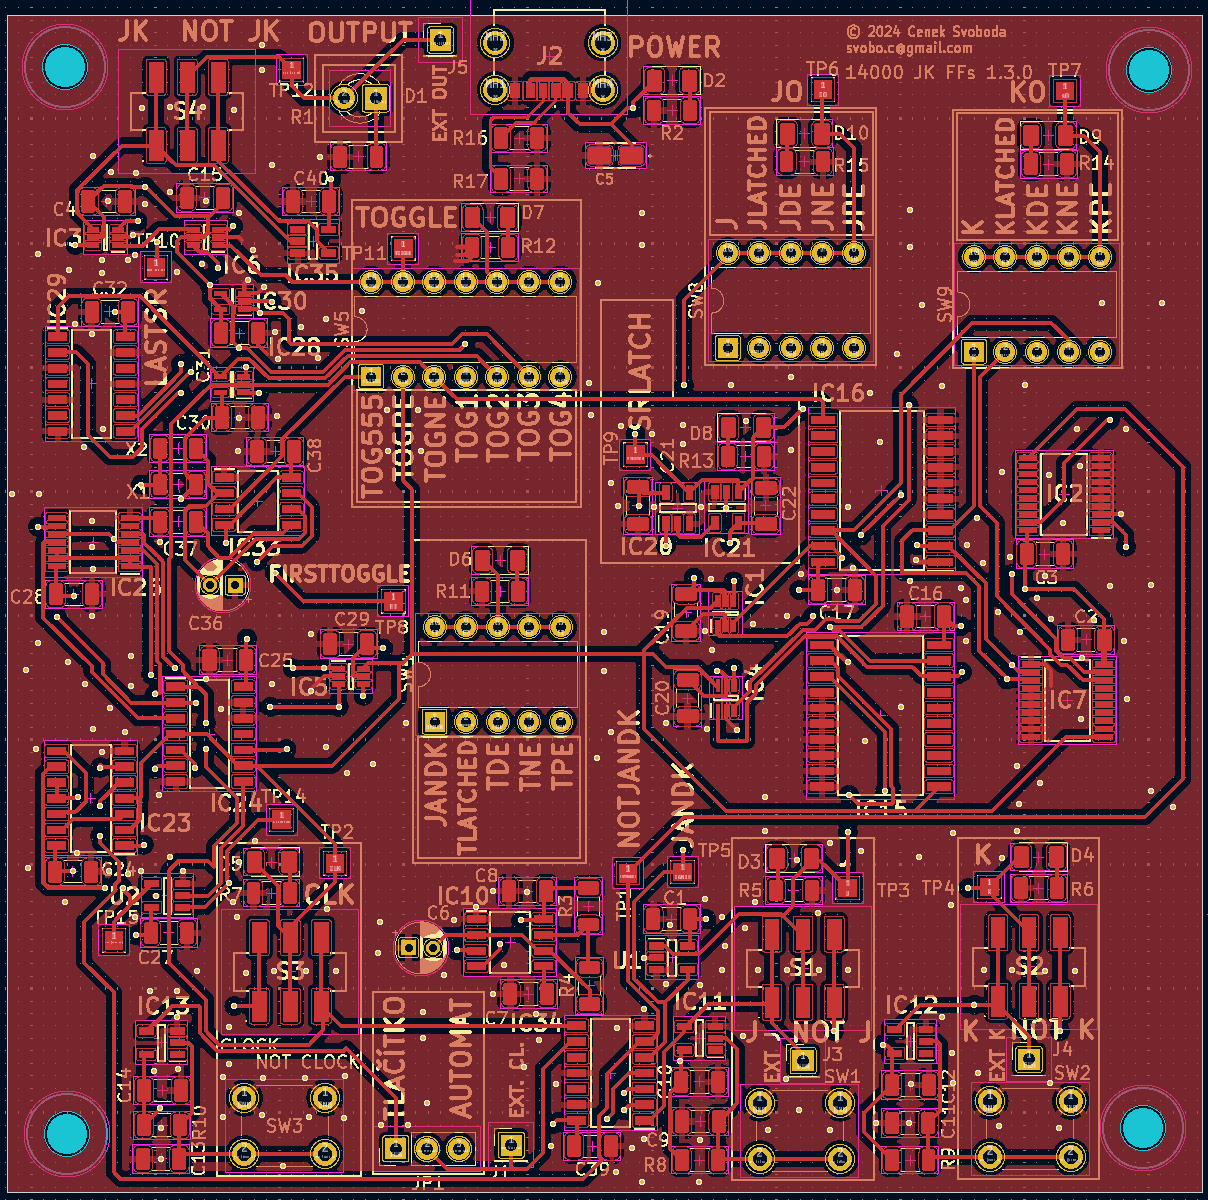
promo1.3.0/440539407_1648068675965915_7974691574529142560_n.png
