cenekSvoboda/14000JKFF/promo1.3.0/440543732_1642667883167258_5391850198760082856_n.png

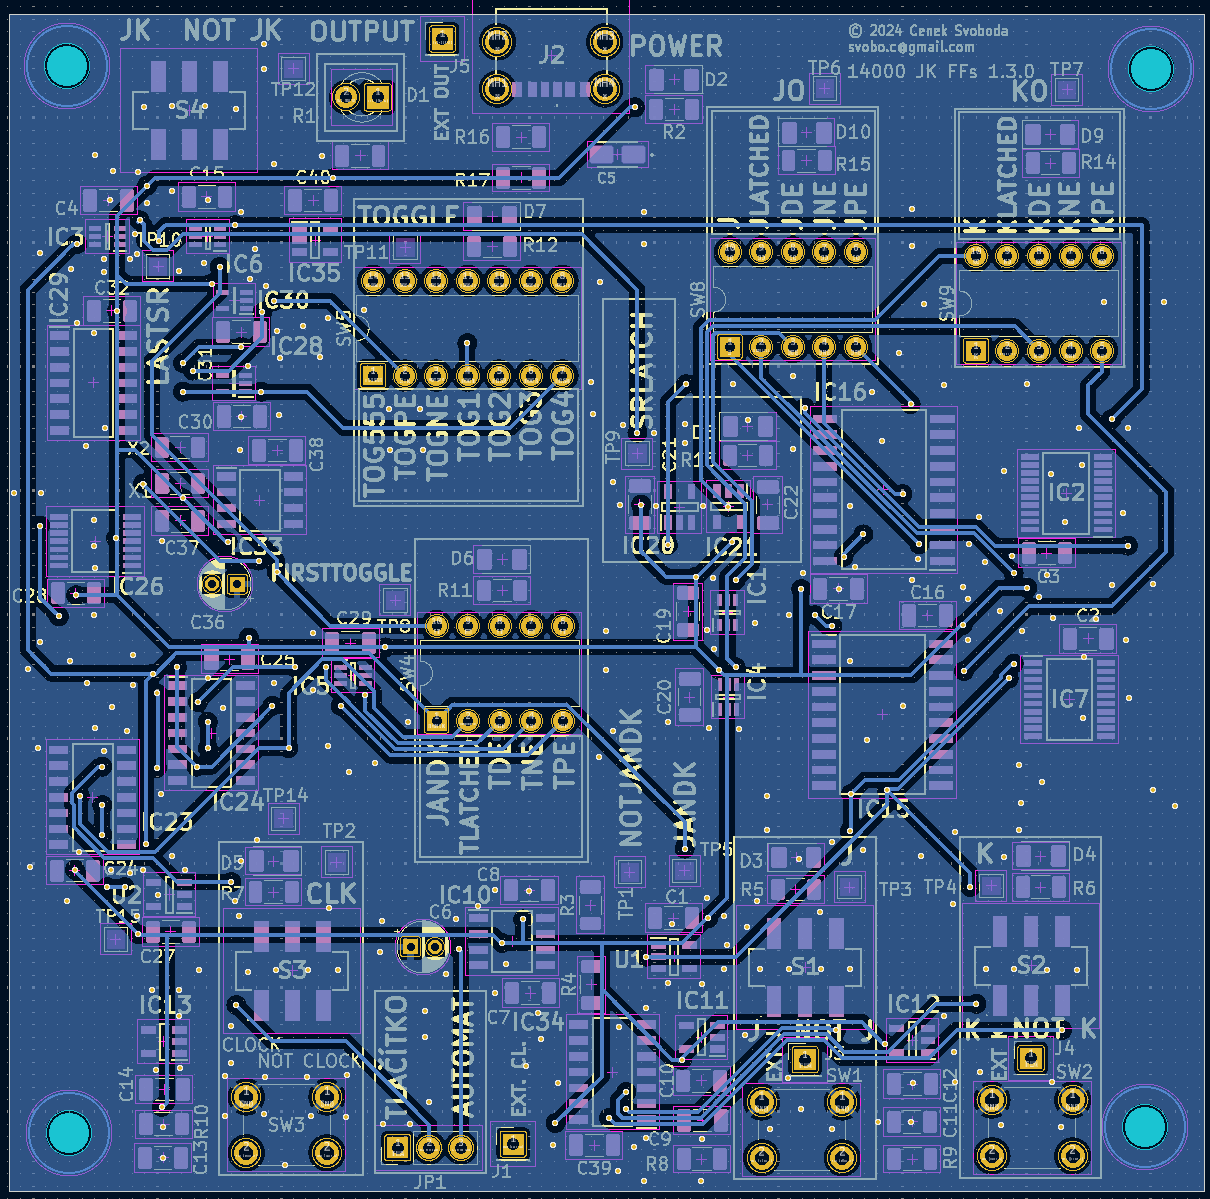
promo1.3.0/440543732_1642667883167258_5391850198760082856_n.png
