cenekSvoboda/14000JKFF/promo/a.png

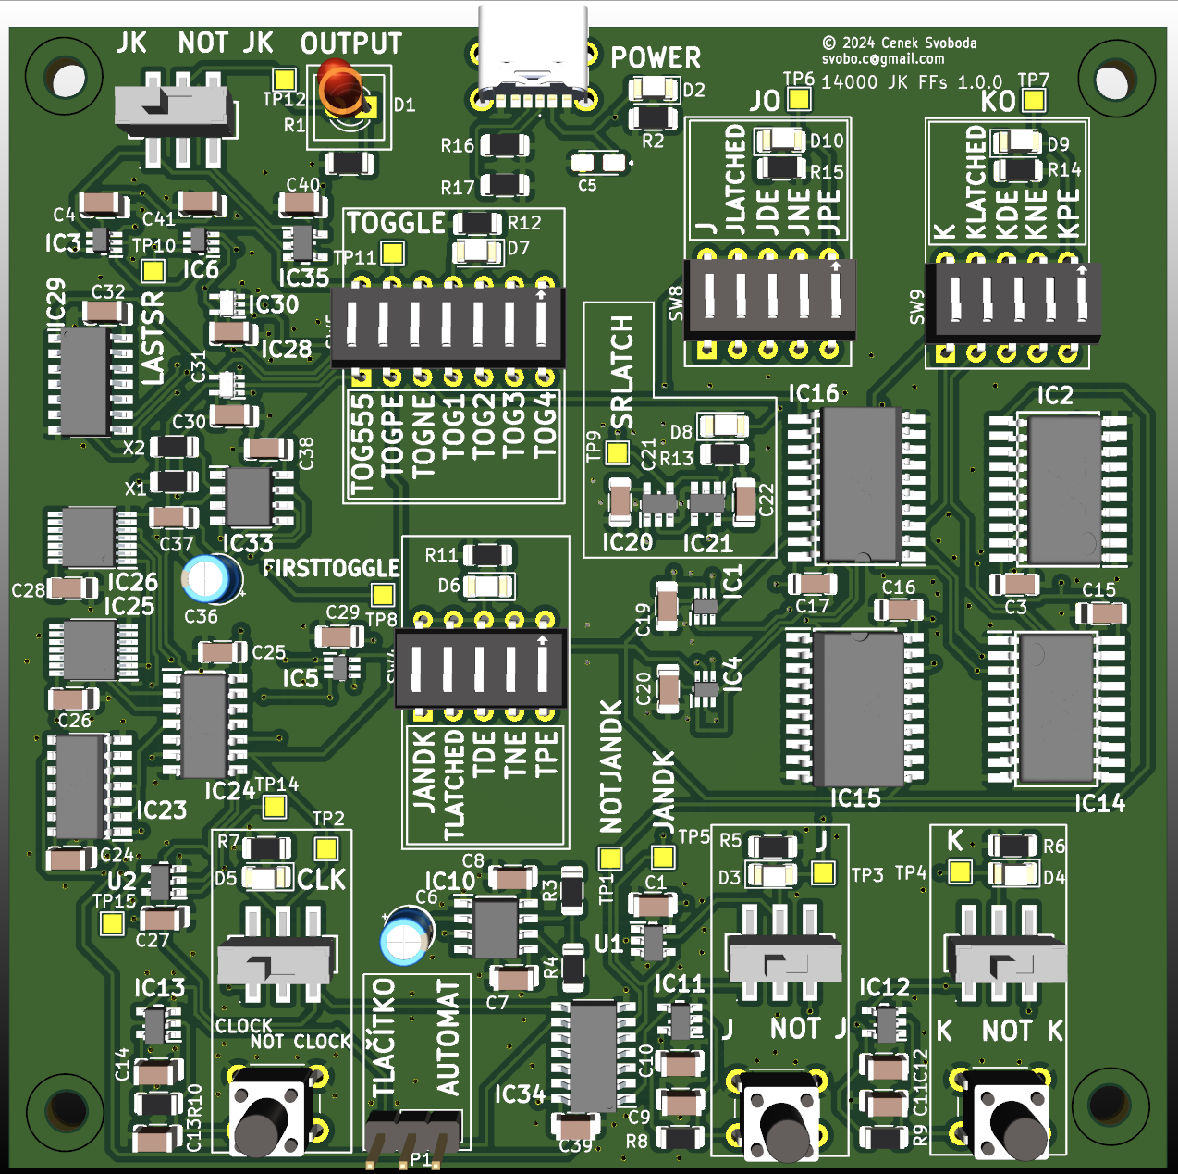
promo/a.png
