cenekSvoboda/14000JKFF/promo/b.png

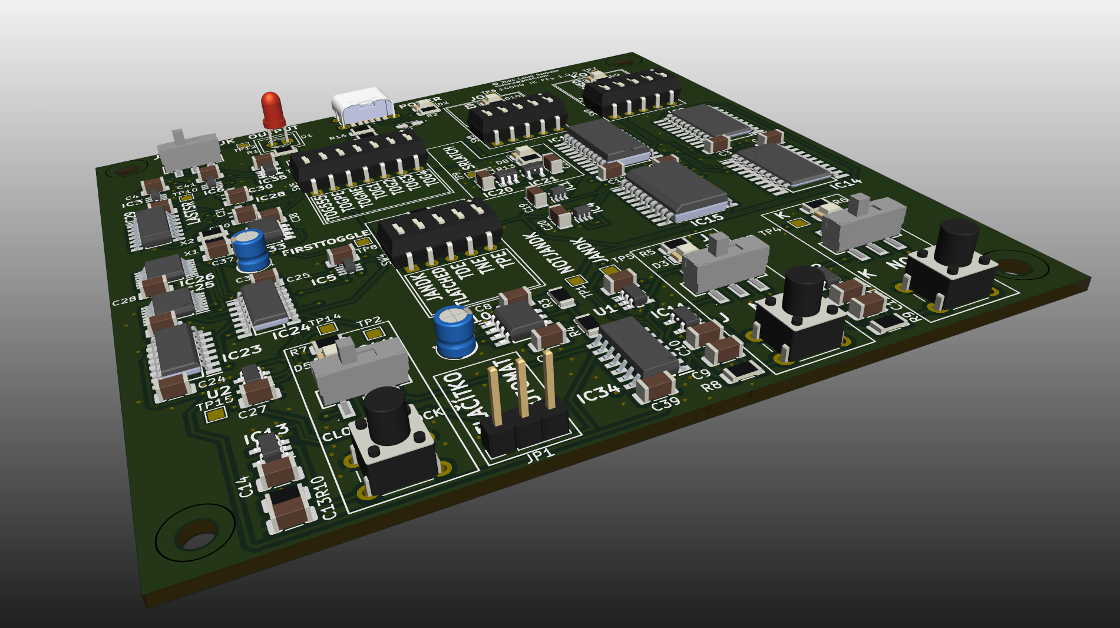
promo/b.png
