cenekSvoboda/14000JKFF/promo/c.png

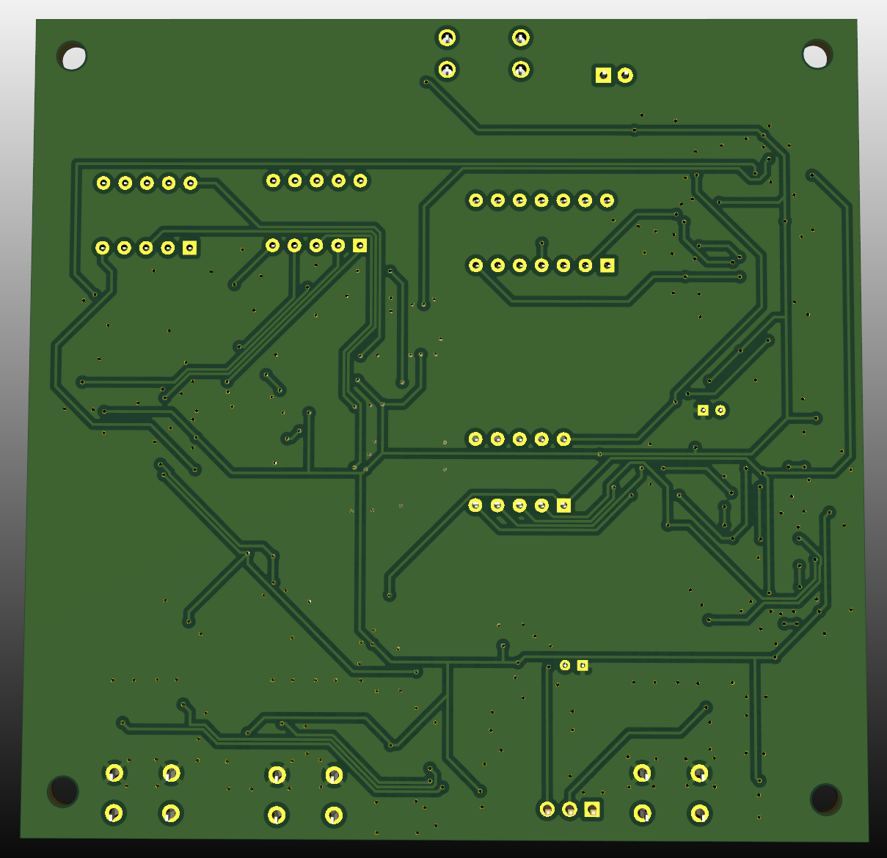
promo/c.png
