cenekSvoboda/14000JKFF/promo/d.png

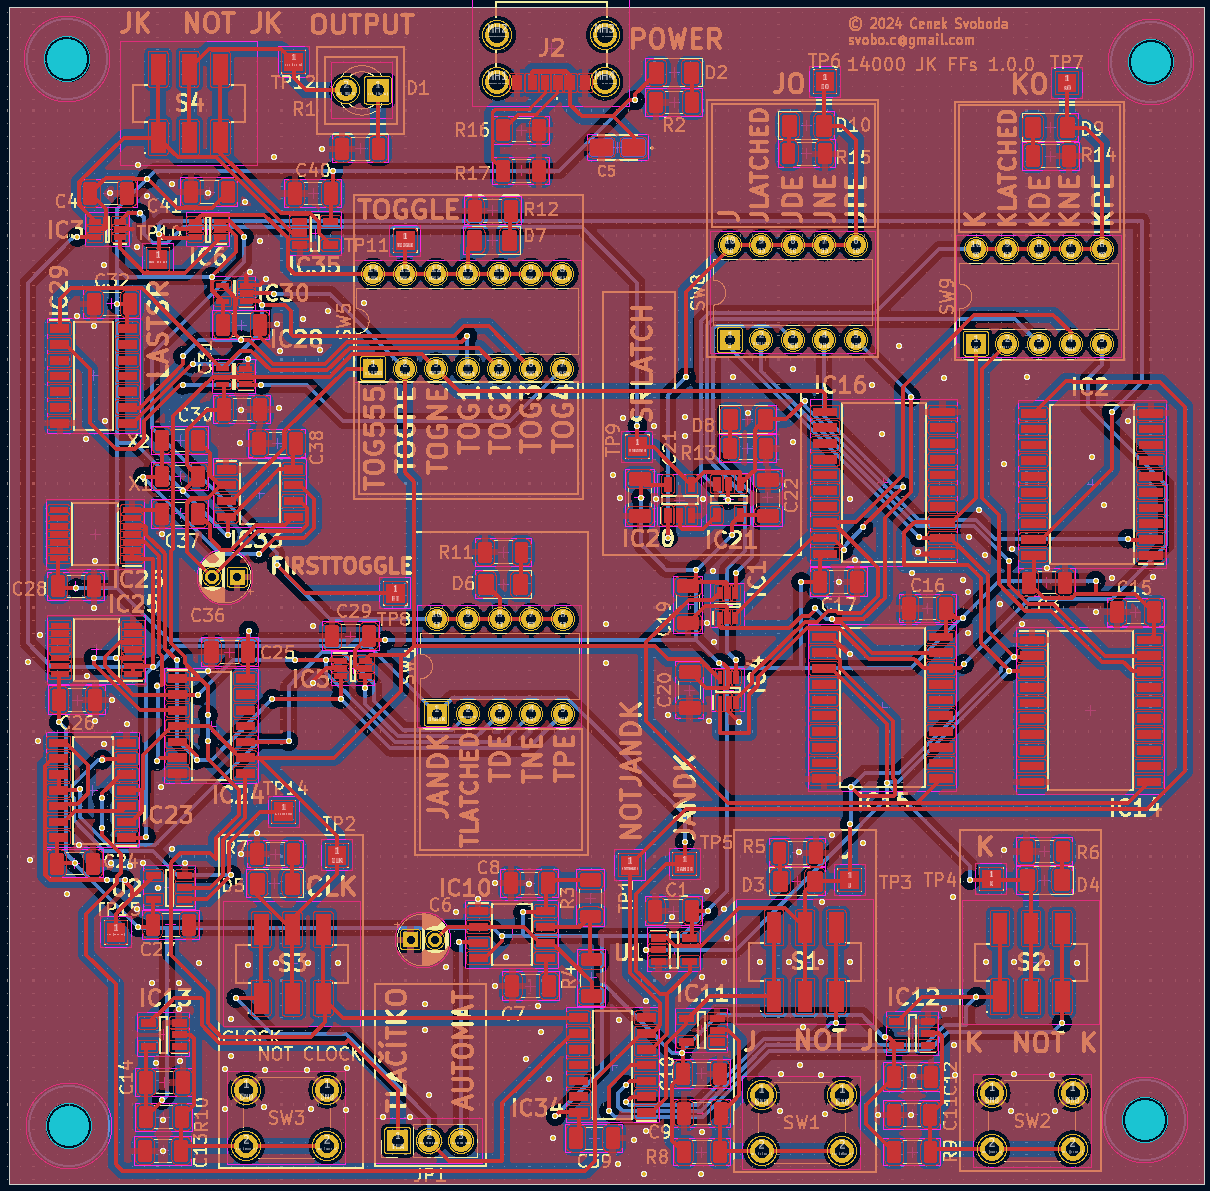
promo/d.png
