cenekSvoboda/14000JKFF/promo/e.png

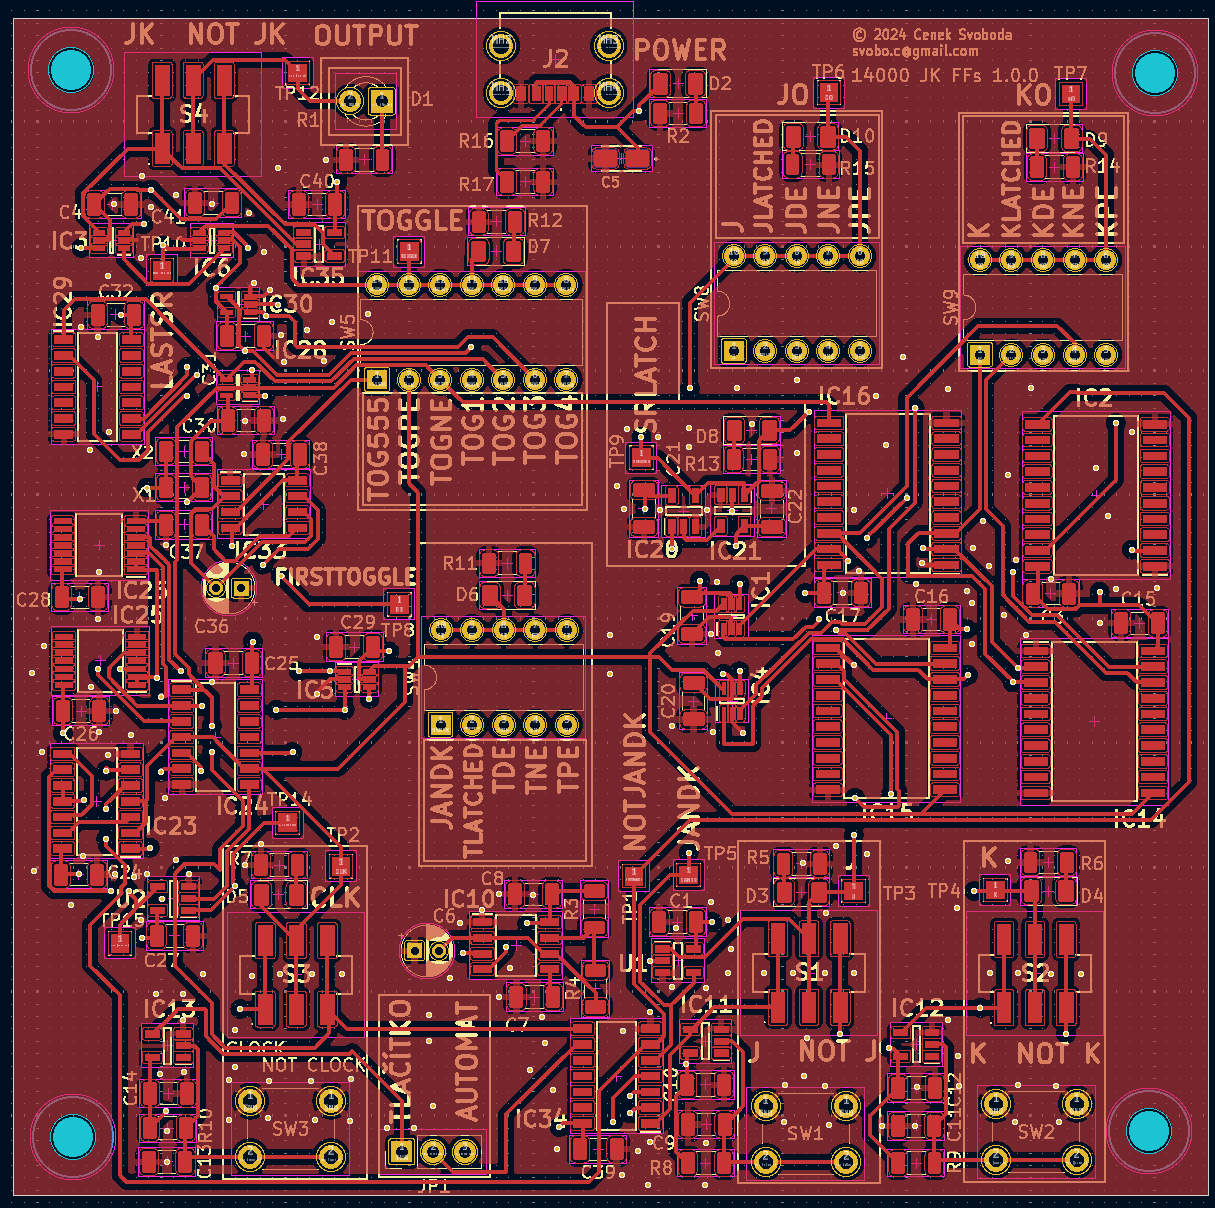
promo/e.png
