cenekSvoboda/14000JKFF/promo/f.png

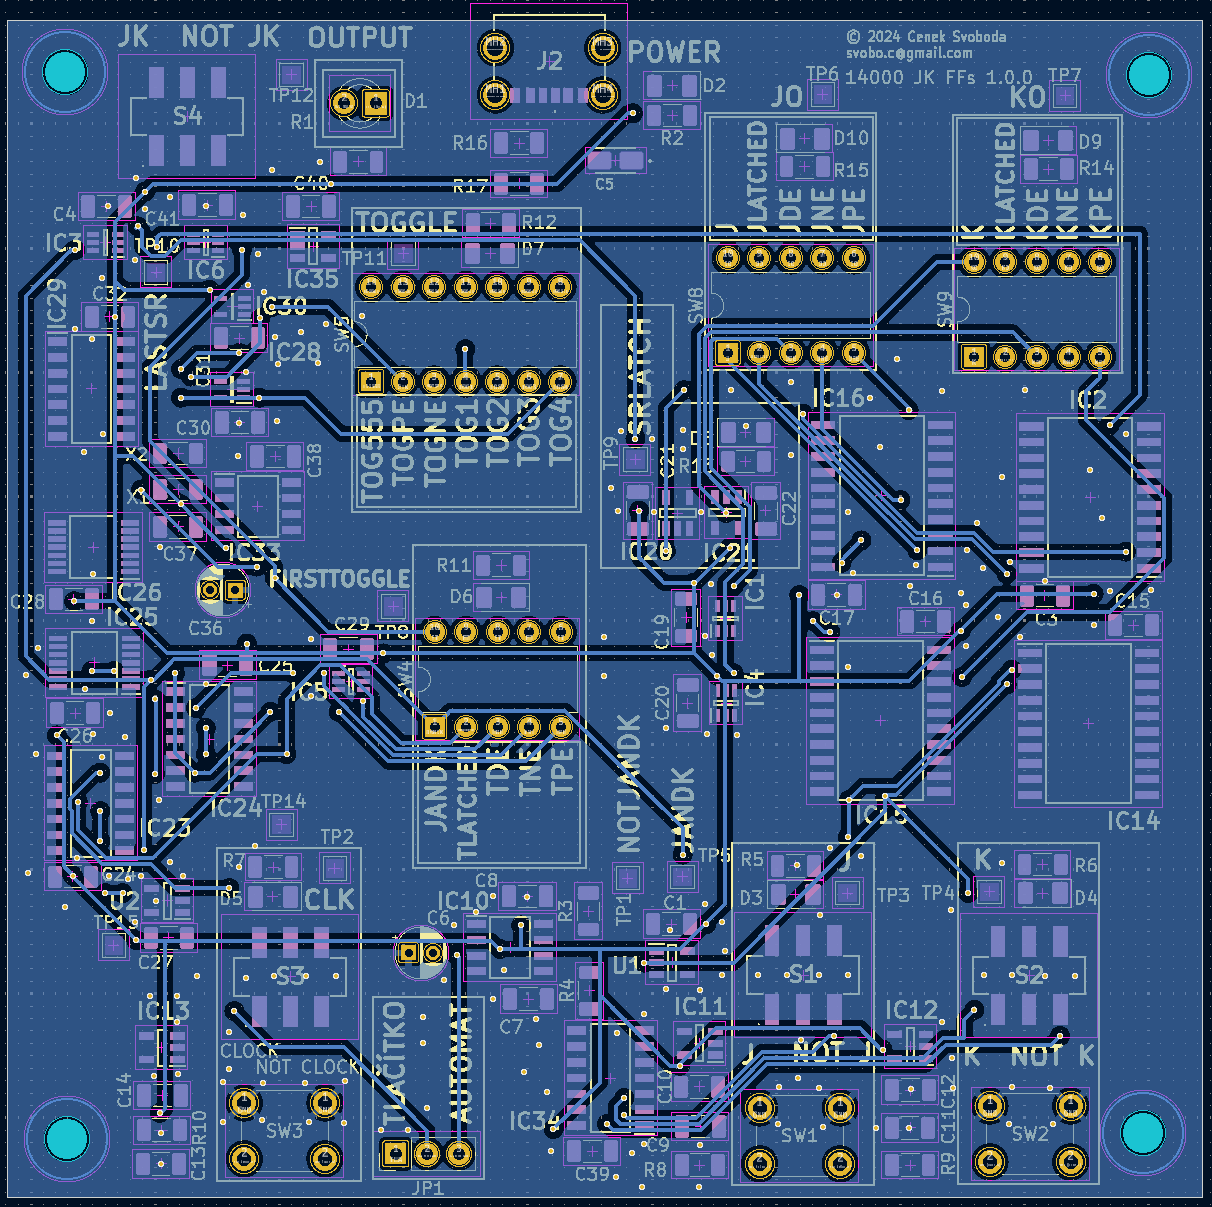
promo/f.png
