cenekSvoboda/14000JKFF/promo/g.png

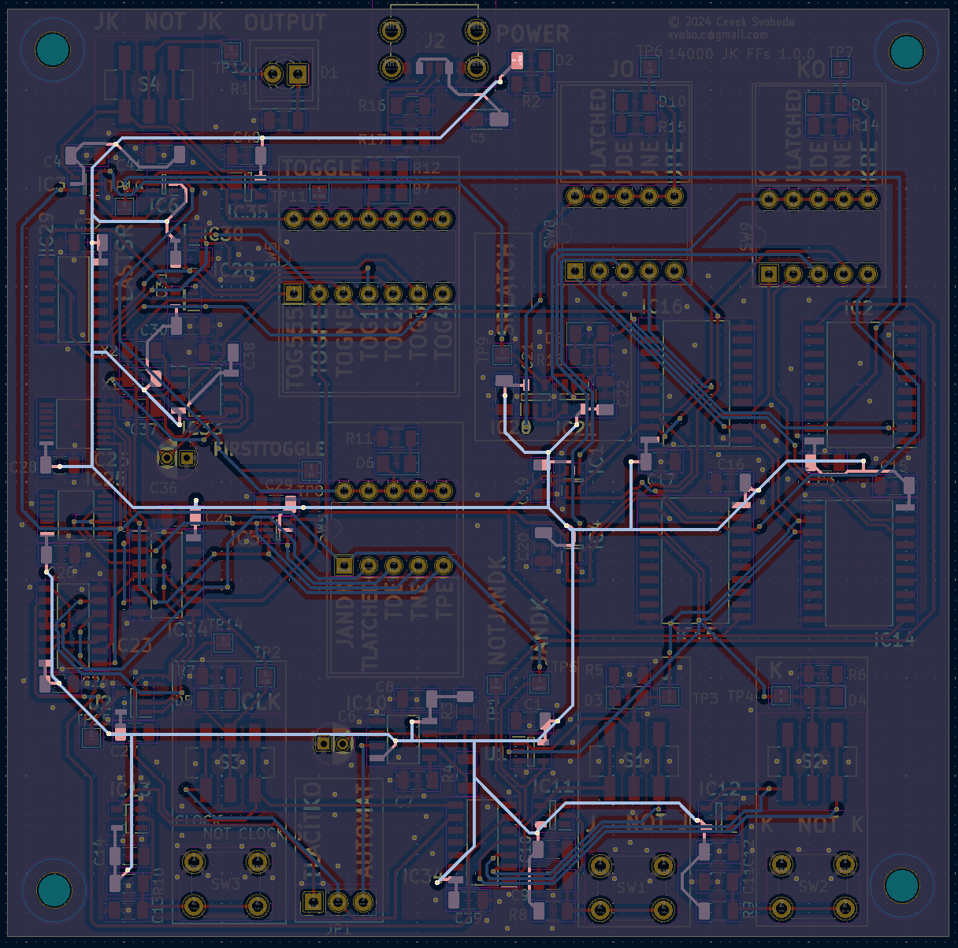
promo/g.png
