cenekSvoboda/14000JKFF/14000JKFF.kicad_pcb

## KiCad design 14000JKFF.kicad_pcb (2024-05-08)

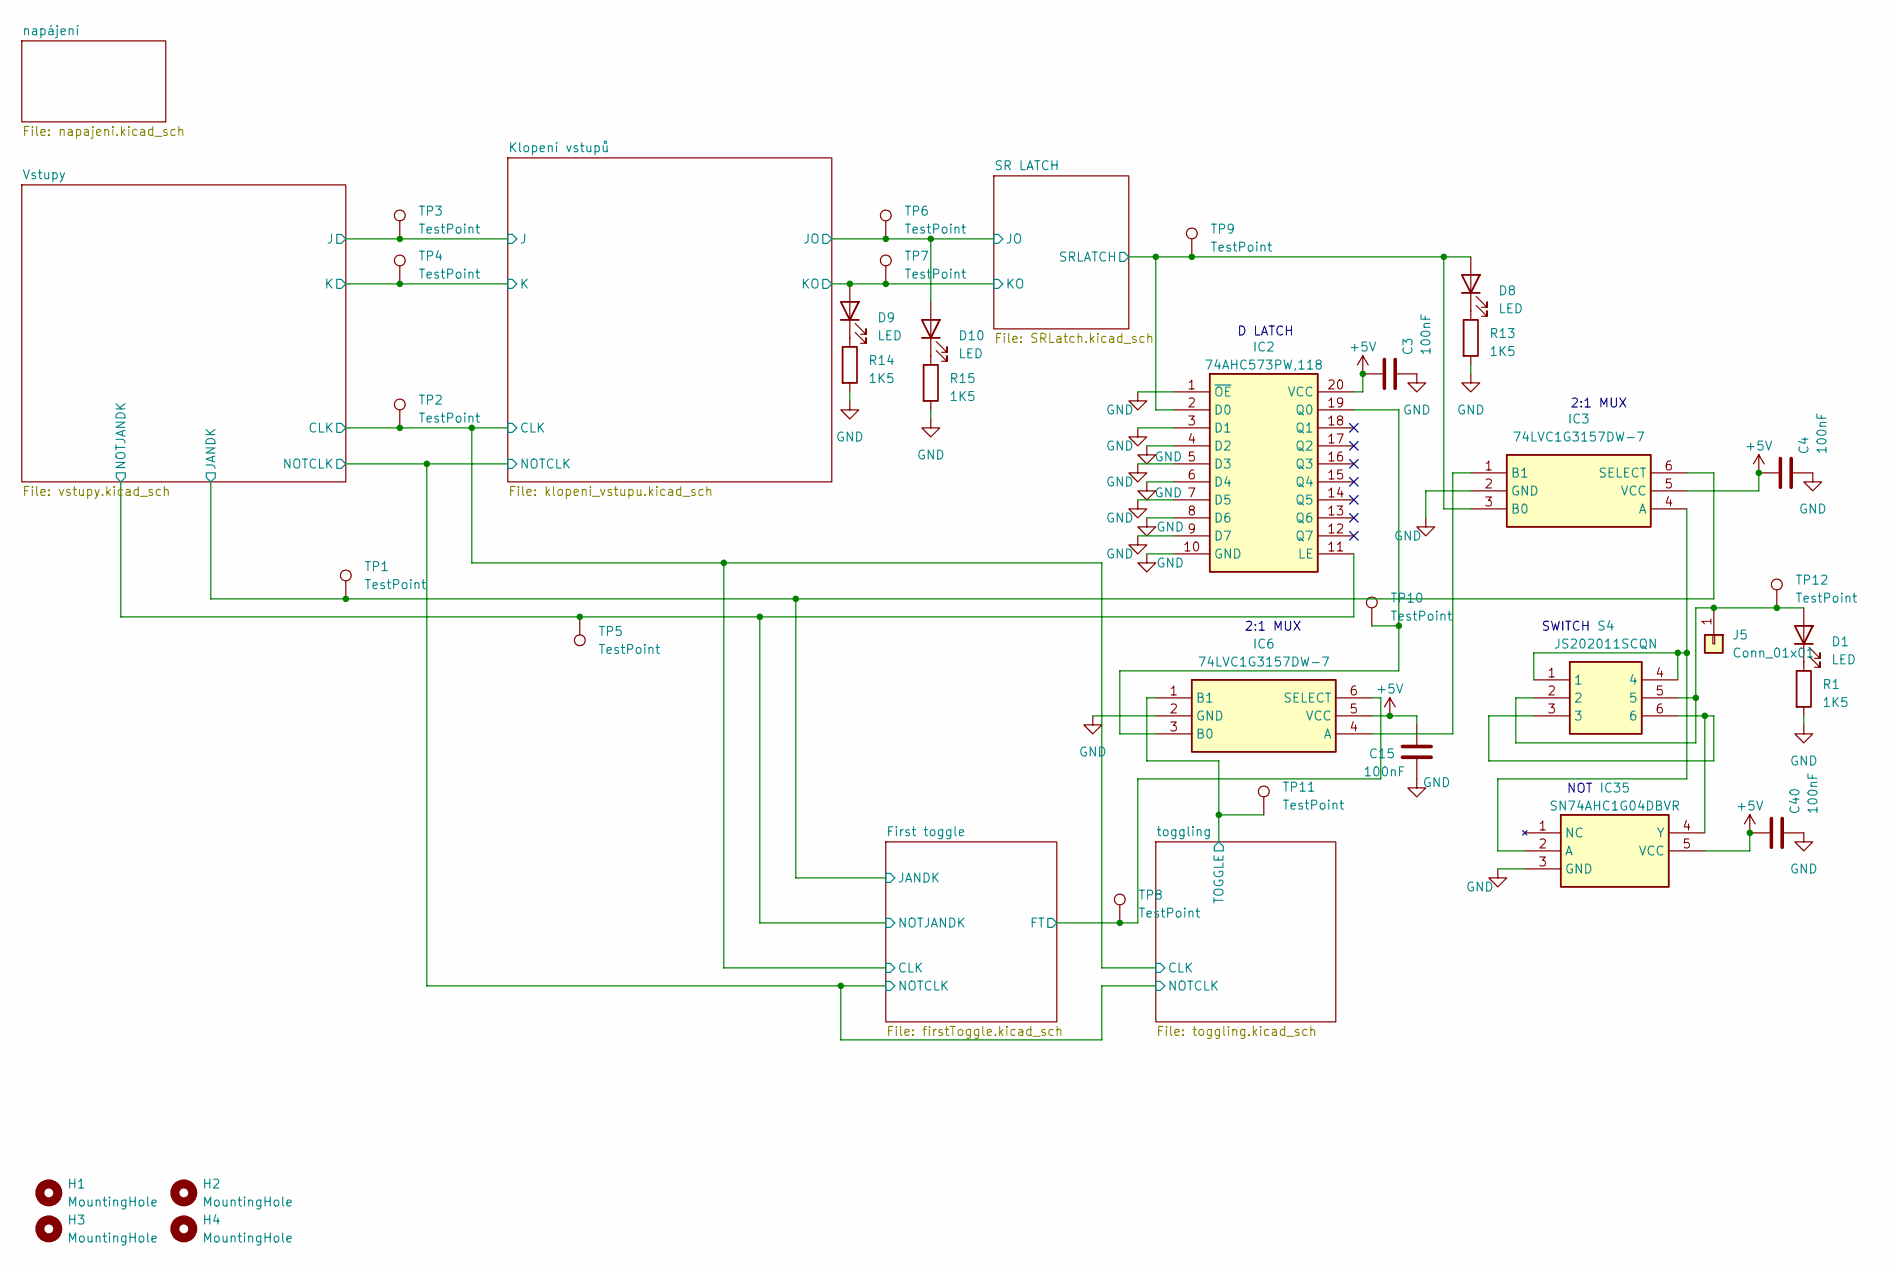
[picture p44: schematic 14000JKFF.kicad_sch]

Parts:
C3, C4, C15, C40: 100nF; C_1206_3216Metric
D1: LED; LED_D3.0mm
D8, D9, D10: LED; LED_1206_3216Metric
H1, H2, H3, H4: MountingHole; MountingHole_3.2mm_M3
IC2: 74AHC573PW,118; SOP65P640X110-20N; Manufacturer_Part_Number 74AHC573PW,118
IC3, IC6: 74LVC1G3157DW-7; SOT65P210X110-6N; Manufacturer_Part_Number 74LVC1G3157DW-7
IC35: SN74AHC1G04DBVR; SOT95P280X145-5N; Manufacturer_Part_Number SN74AHC1G04DBVR
J5: Conn_01x01; PinHeader_1x01_P2.54mm_Vertical
R1, R13, R14, R15: 1K5; R_1206_3216Metric
S4: JS202011SCQN; Manufacturer_Part_Number JS202011SCQN
TP1, TP2, TP3, TP4, TP5, TP6, TP7, TP8, TP9, TP10, TP11, TP12: TestPoint; TestPoint_Pad_1.5x1.5mm

Connections:
+5V: C3.2, C4.2, C15.2, C40.2, IC2.20 (VCC), IC3.5 (VCC), IC6.5 (VCC), IC35.5 (VCC); also elsewhere on the board
/First toggle/CLK: TP2.1; also elsewhere on the board
/First toggle/FT: IC6.6 (SELECT), TP8.1; also elsewhere on the board
/First toggle/JANDK: IC3.6 (SELECT), TP1.1; also elsewhere on the board
/First toggle/NOTJANDK: IC2.11 (LE), TP5.1; also elsewhere on the board
/Klopení vstupů/J: TP3.1; also elsewhere on the board
/Klopení vstupů/JO: D10.2 (A), TP6.1; also elsewhere on the board
/Klopení vstupů/K: TP4.1; also elsewhere on the board
/Klopení vstupů/KO: D9.2 (A), TP7.1; also elsewhere on the board
/SR LATCH/SRLATCH: D8.2 (A), IC2.2 (D0), IC3.3 (B0), TP9.1; also elsewhere on the board
/toggling/TOGGLE: IC6.1 (B1), TP11.1; also elsewhere on the board
GND: C3.1, C4.1, C15.1, C40.1, IC2.1 (~OE), IC2.3 (D1), IC2.4 (D2), IC2.5 (D3), IC2.6 (D4), IC2.7 (D5), IC2.8 (D6), IC2.9 (D7), IC2.10 (GND), IC3.2 (GND), IC6.2 (GND), IC35.3 (GND), R1.2, R13.2, R14.2, R15.2; also elsewhere on the board
unnamed: D1.2 (A), J5.1, S4.2, S4.5, TP12.1
unnamed: D1.1 (K), R1.1
unnamed: D8.1 (K), R13.1
unnamed: D9.1 (K), R14.1
unnamed: D10.1 (K), R15.1
unnamed: IC2.19 (Q0), IC6.3 (B0), TP10.1
unnamed: IC3.4 (A), IC35.2 (A), S4.1, S4.4
unnamed: IC3.1 (B1), IC6.4 (A)
unnamed: IC35.4 (Y), S4.3, S4.6

Notes on the sheet:
NOT
2:1 MUX
D LATCH
SWITCH

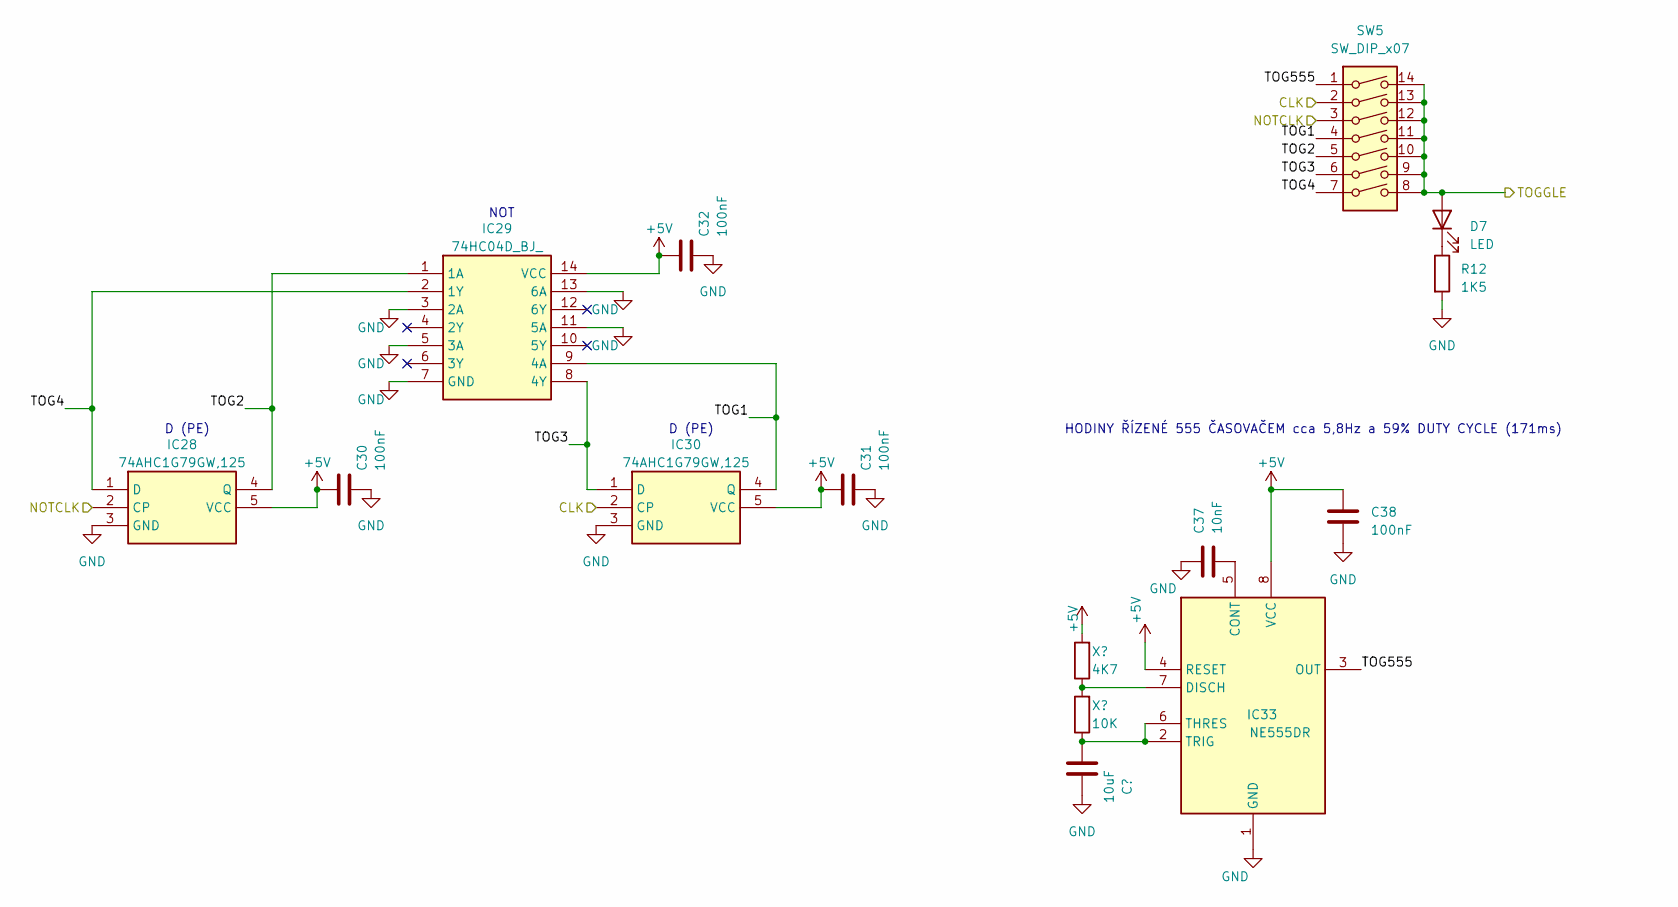
[picture p45: schematic toggling.kicad_sch]

Parts:
C30, C31, C32, C38: 100nF; C_1206_3216Metric
C36: 10uF; CP_Radial_D4.0mm_P2.00mm
C37: 10nF; C_1206_3216Metric
D7: LED; LED_1206_3216Metric
IC28, IC30: 74AHC1G79GW,125; SOT65P212X110-5N; Manufacturer_Part_Number 74AHC1G79GW,125
IC29: 74HC04D_BJ_; SOIC127P600X175-14N; Manufacturer_Part_Number 74HC04D(BJ)
IC33: NE555DR; SOIC127P600X175-8N; Manufacturer_Part_Number NE555DR
R12: 1K5; R_1206_3216Metric
SW5: SW_DIP_x07; DIP-14_W7.62mm
X1: 4K7; R_1206_3216Metric
X2: 10K; R_1206_3216Metric

Connections:
+5V: C30.2, C31.2, C32.2, C38.2, IC28.5 (VCC), IC29.14 (VCC), IC30.5 (VCC), IC33.4 (RESET), IC33.8 (VCC), X1.2; also elsewhere on the board
/First toggle/CLK: IC30.2 (CP), SW5.2; also elsewhere on the board
/First toggle/NOTCLK: IC28.2 (CP), SW5.3; also elsewhere on the board
/toggling/TOG1: IC29.9 (4A), IC30.4 (Q), SW5.4
/toggling/TOG2: IC28.4 (Q), IC29.1 (1A), SW5.5
/toggling/TOG3: IC29.8 (4Y), IC30.1 (D), SW5.6
/toggling/TOG4: IC28.1 (D), IC29.2 (1Y), SW5.7
/toggling/TOG555: IC33.3 (OUT), SW5.1
/toggling/TOGGLE: D7.2 (A), SW5.8, SW5.9, SW5.10, SW5.11, SW5.12, SW5.13, SW5.14; also elsewhere on the board
GND: C30.1, C31.1, C32.1, C36.1, C37.1, C38.1, IC28.3 (GND), IC29.3 (2A), IC29.5 (3A), IC29.7 (GND), IC29.11 (5A), IC29.13 (6A), IC30.3 (GND), IC33.1 (GND), R12.2; also elsewhere on the board
unnamed: D7.1 (K), R12.1
unnamed: C37.2, IC33.5 (CONT)
unnamed: IC33.7 (DISCH), X1.1, X2.2
unnamed: C36.2, IC33.2 (TRIG), IC33.6 (THRES), X2.1

Notes on the sheet:
NOT
D (PE)
HODINY ŘÍZENÉ 555 ČASOVAČEM cca 5,8Hz a 59% DUTY CYCLE (171ms)

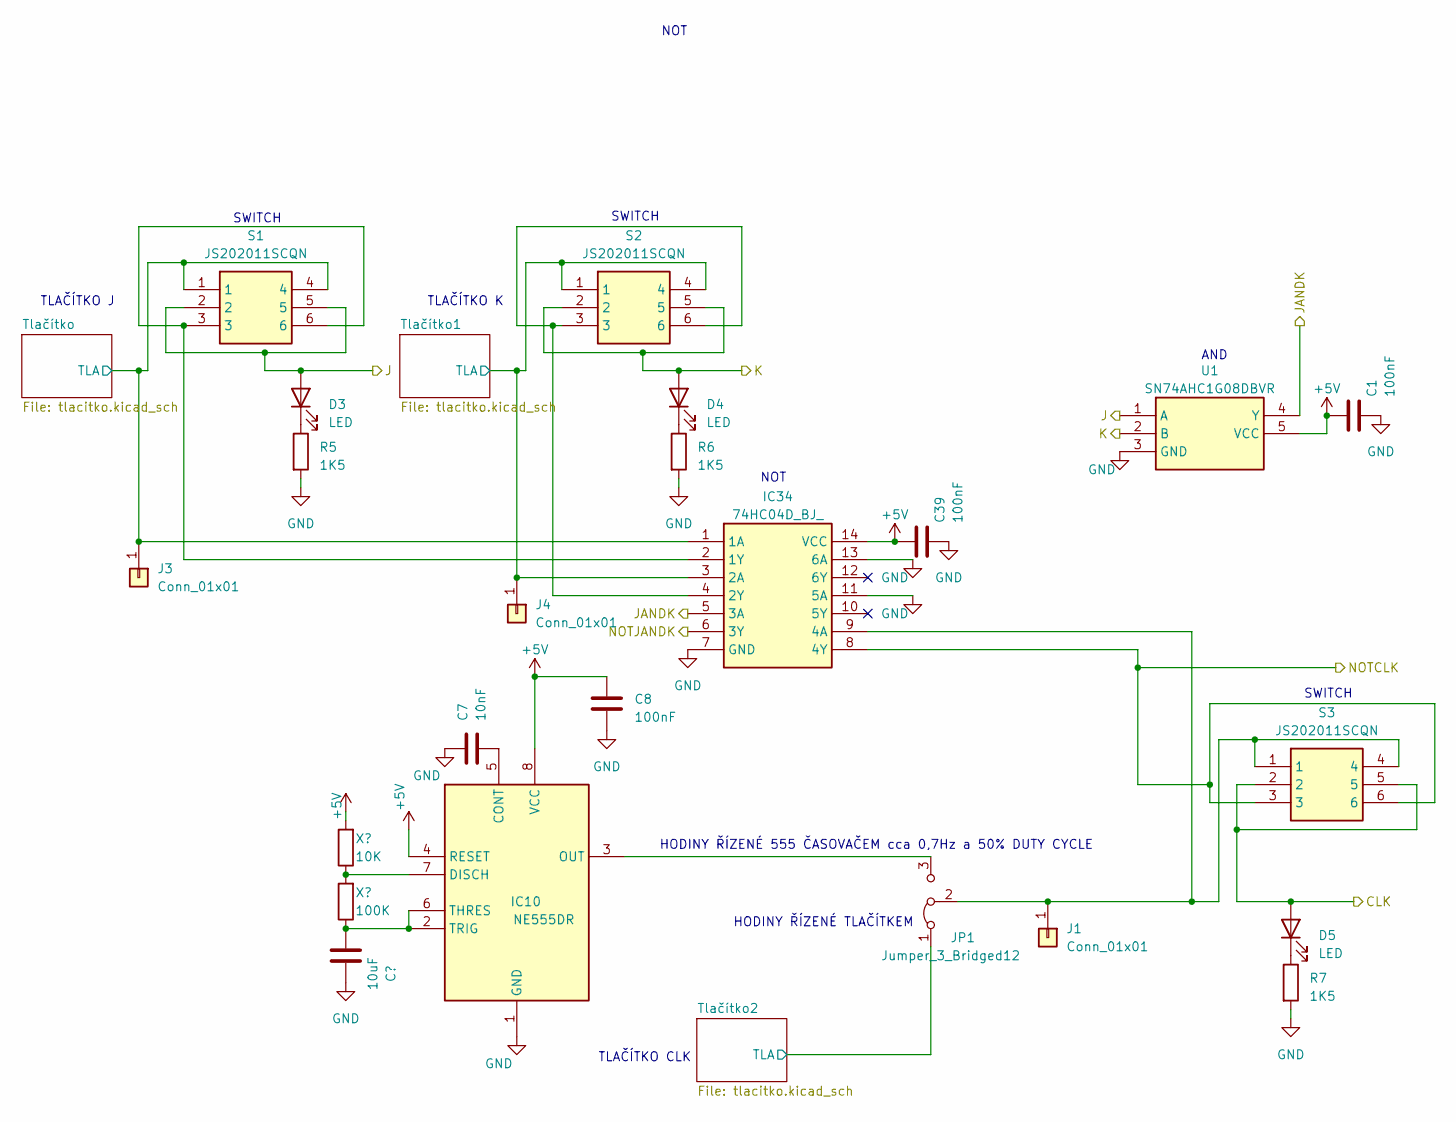
[picture p46: schematic vstupy.kicad_sch]

Parts:
C1, C8, C39: 100nF; C_1206_3216Metric
C6: 10uF; CP_Radial_D4.0mm_P2.00mm
C7: 10nF; C_1206_3216Metric
D3, D4, D5: LED; LED_1206_3216Metric
IC10: NE555DR; SOIC127P600X175-8N; Manufacturer_Part_Number NE555DR
IC34: 74HC04D_BJ_; SOIC127P600X175-14N; Manufacturer_Part_Number 74HC04D(BJ)
J1, J3, J4: Conn_01x01; PinHeader_1x01_P2.54mm_Vertical
JP1: Jumper_3_Bridged12; PinHeader_1x03_P2.54mm_Vertical
R3: 10K; R_1206_3216Metric
R4: 100K; R_1206_3216Metric
R5, R6, R7: 1K5; R_1206_3216Metric
S1, S2, S3: JS202011SCQN; Manufacturer_Part_Number JS202011SCQN
U1: SN74AHC1G08DBVR; SOT95P280X145-5N; Manufacturer_Part_Number SN74AHC1G08DBVR

Connections:
+5V: C1.2, C8.2, C39.2, IC10.4 (RESET), IC10.8 (VCC), IC34.14 (VCC), R3.2, U1.5 (VCC); also elsewhere on the board
/First toggle/CLK: D5.2 (A), S3.2, S3.5; also elsewhere on the board
/First toggle/JANDK: IC34.5 (3A), U1.4 (Y); also elsewhere on the board
/First toggle/NOTCLK: IC34.8 (4Y), S3.3, S3.6; also elsewhere on the board
/First toggle/NOTJANDK: IC34.6 (3Y); also elsewhere on the board
/Klopení vstupů/J: D3.2 (A), S1.2, S1.5, U1.1 (A); also elsewhere on the board
/Klopení vstupů/K: D4.2 (A), S2.2, S2.5, U1.2 (B); also elsewhere on the board
/Vstupy/Tlačítko1/TLA: IC34.3 (2A), J4.1, S2.1, S2.4; also elsewhere on the board
/Vstupy/Tlačítko2/TLA: JP1.1 (A); also elsewhere on the board
/Vstupy/Tlačítko/TLA: IC34.1 (1A), J3.1, S1.1, S1.4; also elsewhere on the board
GND: C1.1, C6.1, C7.1, C8.1, C39.1, IC10.1 (GND), IC34.7 (GND), IC34.11 (5A), IC34.13 (6A), R5.2, R6.2, R7.2, U1.3 (GND); also elsewhere on the board
unnamed: D3.1 (K), R5.1
unnamed: D4.1 (K), R6.1
unnamed: D5.1 (K), R7.1
unnamed: C7.2, IC10.5 (CONT)
unnamed: IC10.7 (DISCH), R3.1, R4.2
unnamed: IC10.3 (OUT), JP1.3 (B)
unnamed: C6.2, IC10.2 (TRIG), IC10.6 (THRES), R4.1
unnamed: IC34.2 (1Y), S1.3, S1.6
unnamed: IC34.4 (2Y), S2.3, S2.6
unnamed: IC34.9 (4A), J1.1, JP1.2 (C), S3.1, S3.4

Notes on the sheet:
HODINY ŘÍZENÉ 555 ČASOVAČEM cca 0,7Hz a 50% DUTY CYCLE
SWITCH
NOT
TLAČÍTKO K
HODINY ŘÍZENÉ TLAČÍTKEM
AND
TLAČÍTKO J
TLAČÍTKO CLK

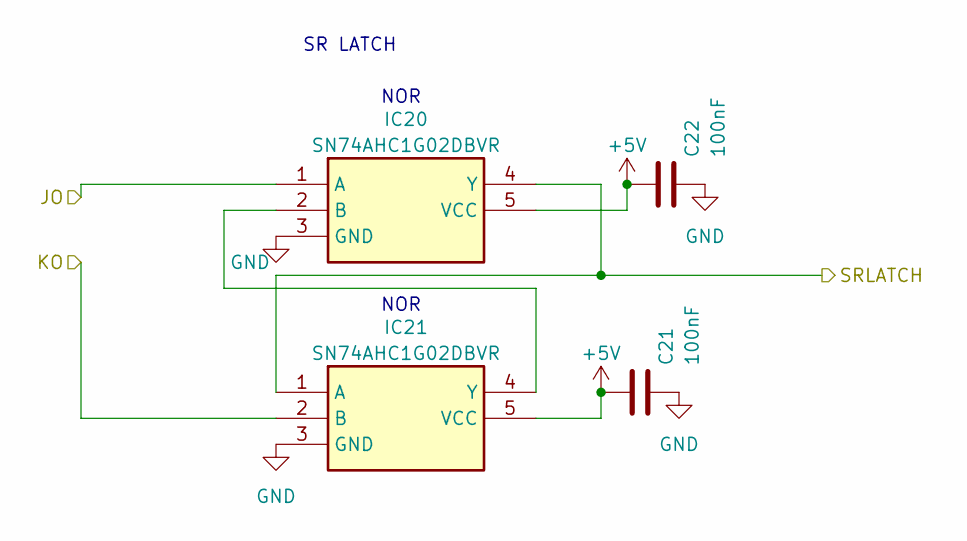
[picture p47: schematic SRLatch.kicad_sch]

Parts:
C21, C22: 100nF; C_1206_3216Metric
IC20, IC21: SN74AHC1G02DBVR; SOT95P280X145-5N; Manufacturer_Part_Number SN74AHC1G02DBVR

Connections:
+5V: C21.2, C22.2, IC20.5 (VCC), IC21.5 (VCC); also elsewhere on the board
/Klopení vstupů/JO: IC20.1 (A); also elsewhere on the board
/Klopení vstupů/KO: IC21.2 (B); also elsewhere on the board
/SR LATCH/SRLATCH: IC20.4 (Y), IC21.1 (A); also elsewhere on the board
GND: C21.1, C22.1, IC20.3 (GND), IC21.3 (GND); also elsewhere on the board
unnamed: IC20.2 (B), IC21.4 (Y)

Notes on the sheet:
NOR
SR LATCH

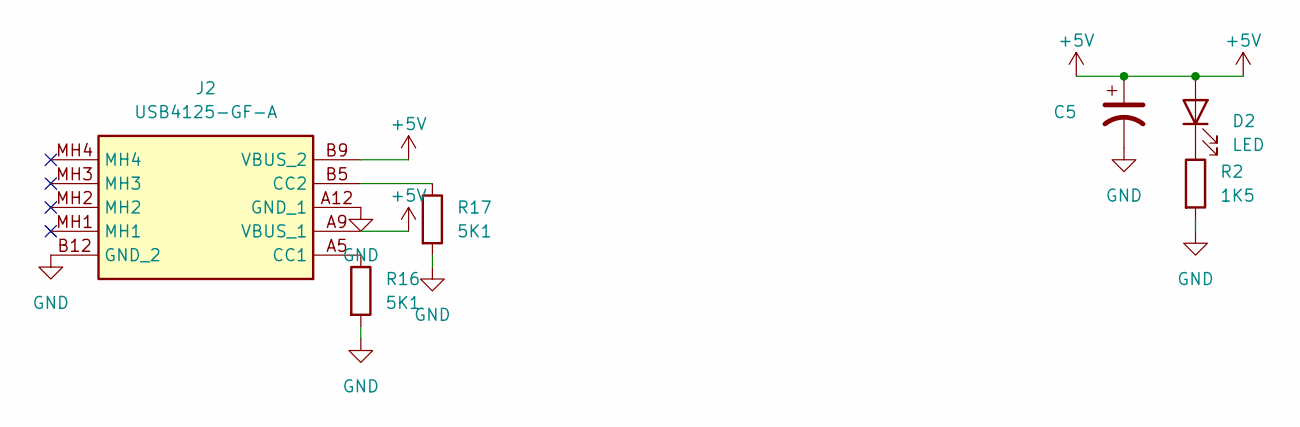
[picture p48: schematic napajeni.kicad_sch]

Parts:
C5: 293D106X96R3A2TE3; CAPMP3216X180N
D2: LED; LED_1206_3216Metric
J2: USB4125-GF-A; USB4125GFA; Manufacturer_Part_Number USB4125-GF-A
R2: 1K5; R_1206_3216Metric
R16, R17: 5K1; R_1206_3216Metric

Connections:
+5V: C5.1, D2.2 (A), J2.A9 (VBUS_1), J2.B9 (VBUS_2); also elsewhere on the board
GND: C5.2, J2.A12 (GND_1), J2.B12 (GND_2), R2.2, R16.2, R17.2; also elsewhere on the board
unnamed: D2.1 (K), R2.1
unnamed: J2.A5 (CC1), R16.1
unnamed: J2.B5 (CC2), R17.1

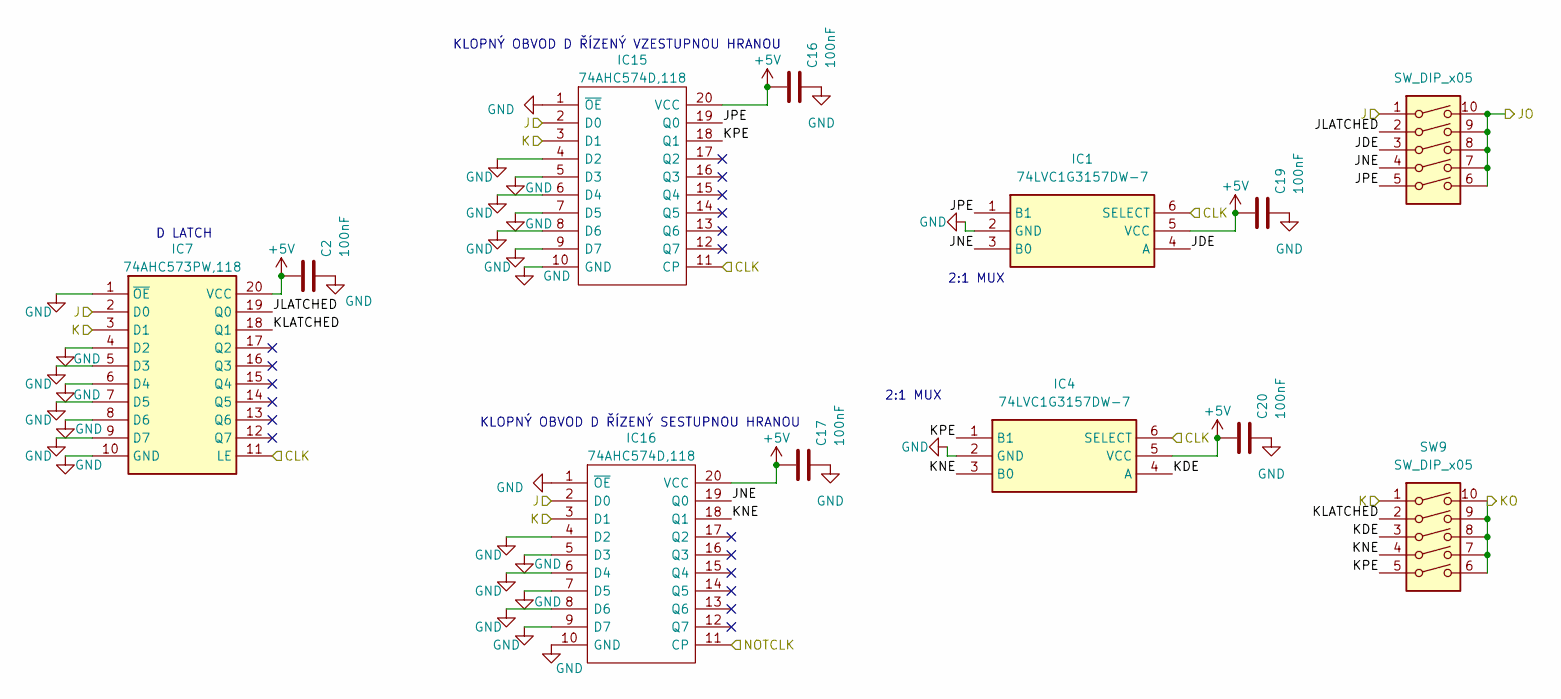
[picture p49: schematic klopeni_vstupu.kicad_sch]

Parts:
C2, C16, C17, C19, C20: 100nF; C_1206_3216Metric
IC1, IC4: 74LVC1G3157DW-7; SOT65P210X110-6N; Manufacturer_Part_Number 74LVC1G3157DW-7
IC7: 74AHC573PW,118; SOP65P640X110-20N; Manufacturer_Part_Number 74AHC573PW,118
IC15, IC16: 74AHC574D,118; SOIC127P1032X265-20N; Manufacturer_Part_Number 74AHC574D,118
SW8, SW9: SW_DIP_x05; DIP-10_W7.62mm

Connections:
+5V: C2.2, C16.2, C17.2, C19.2, C20.2, IC1.5 (VCC), IC4.5 (VCC), IC7.20 (VCC), IC15.20 (VCC), IC16.20 (VCC); also elsewhere on the board
/First toggle/CLK: IC1.6 (SELECT), IC4.6 (SELECT), IC7.11 (LE), IC15.11 (CP); also elsewhere on the board
/First toggle/NOTCLK: IC16.11 (CP); also elsewhere on the board
/Klopení vstupů/J: IC7.2 (D0), IC15.2 (D0), IC16.2 (D0), SW8.1; also elsewhere on the board
/Klopení vstupů/JDE: IC1.4 (A), SW8.3
/Klopení vstupů/JLATCHED: IC7.19 (Q0), SW8.2
/Klopení vstupů/JNE: IC1.3 (B0), IC16.19 (Q0), SW8.4
/Klopení vstupů/JO: SW8.6, SW8.7, SW8.8, SW8.9, SW8.10; also elsewhere on the board
/Klopení vstupů/JPE: IC1.1 (B1), IC15.19 (Q0), SW8.5
/Klopení vstupů/K: IC7.3 (D1), IC15.3 (D1), IC16.3 (D1), SW9.1; also elsewhere on the board
/Klopení vstupů/KDE: IC4.4 (A), SW9.3
/Klopení vstupů/KLATCHED: IC7.18 (Q1), SW9.2
/Klopení vstupů/KNE: IC4.3 (B0), IC16.18 (Q1), SW9.4
/Klopení vstupů/KO: SW9.6, SW9.7, SW9.8, SW9.9, SW9.10; also elsewhere on the board
/Klopení vstupů/KPE: IC4.1 (B1), IC15.18 (Q1), SW9.5
GND: C2.1, C16.1, C17.1, C19.1, C20.1, IC1.2 (GND), IC4.2 (GND), IC7.1 (~OE), IC7.4 (D2), IC7.5 (D3), IC7.6 (D4), IC7.7 (D5), IC7.8 (D6), IC7.9 (D7), IC7.10 (GND), IC15.1 (~OE), IC15.4 (D2), IC15.5 (D3), IC15.6 (D4), IC15.7 (D5), IC15.8 (D6), IC15.9 (D7), IC15.10 (GND), IC16.1 (~OE), IC16.4 (D2), IC16.5 (D3), IC16.6 (D4), IC16.7 (D5), IC16.8 (D6), IC16.9 (D7), IC16.10 (GND); also elsewhere on the board

Notes on the sheet:
KLOPNÝ OBVOD D ŘÍZENÝ VZESTUPNOU HRANOU
2:1 MUX
KLOPNÝ OBVOD D ŘÍZENÝ SESTUPNOU HRANOU
D LATCH

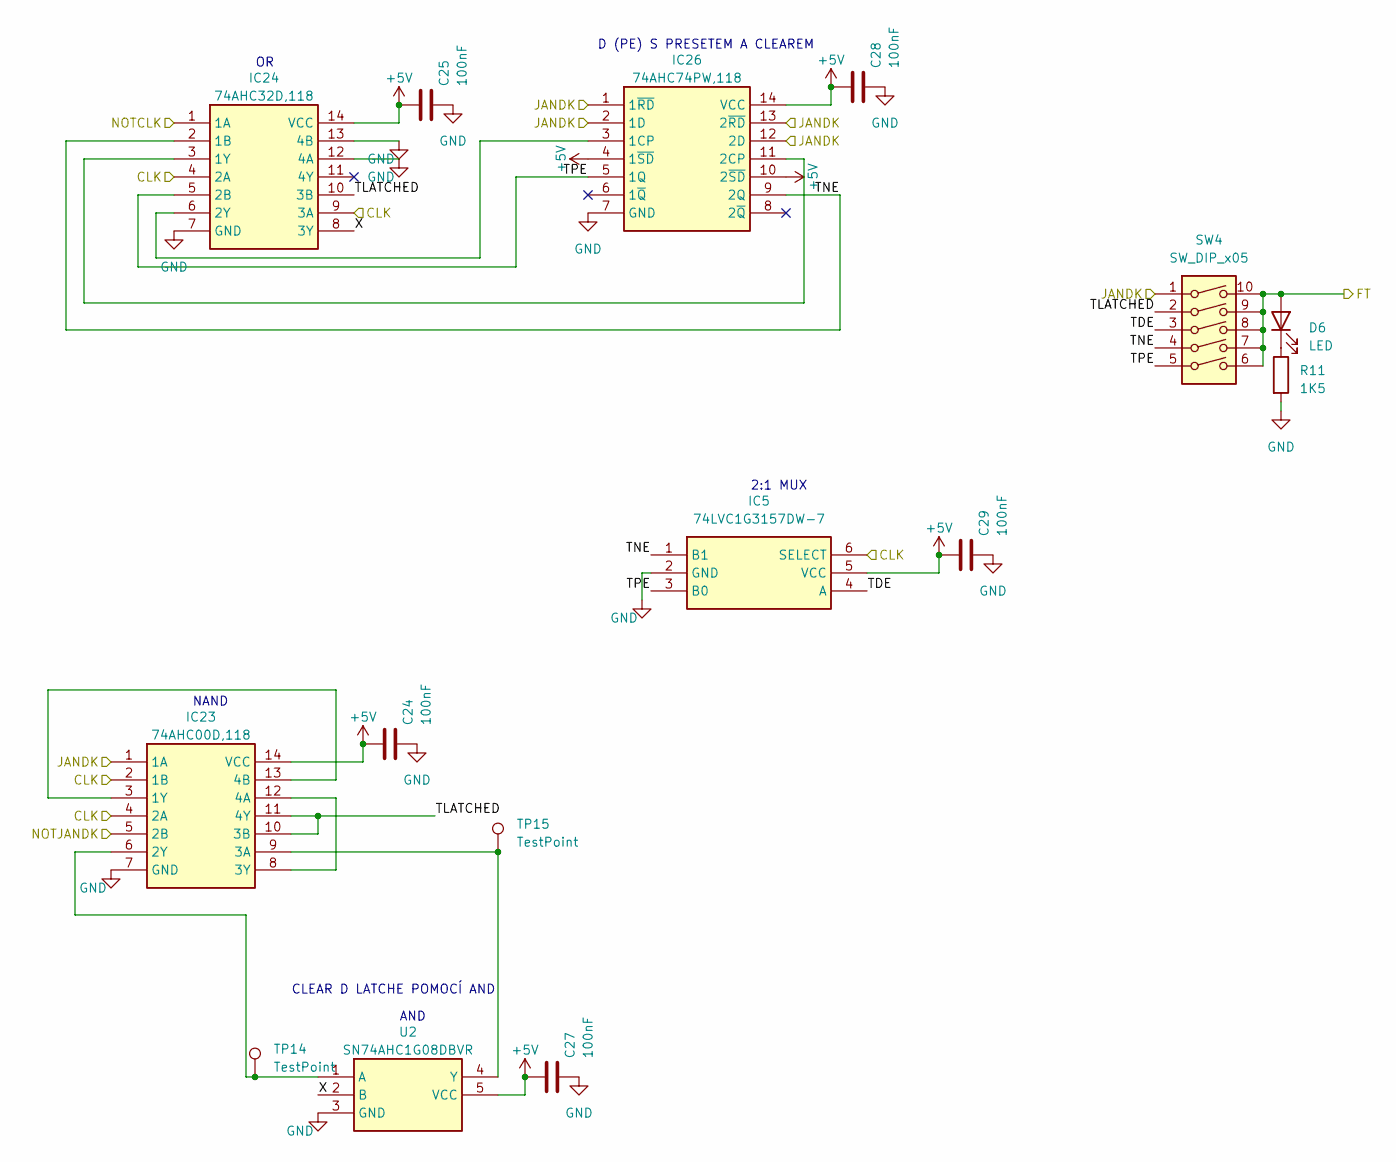
[picture p50: schematic firstToggle.kicad_sch]

Parts:
C24, C25, C27, C28, C29: 100nF; C_1206_3216Metric
D6: LED; LED_1206_3216Metric
IC5: 74LVC1G3157DW-7; SOT65P210X110-6N; Manufacturer_Part_Number 74LVC1G3157DW-7
IC23: 74AHC00D,118; SOIC127P600X175-14N; Manufacturer_Part_Number 74AHC00D,118
IC24: 74AHC32D,118; SOIC127P600X175-14N; Manufacturer_Part_Number 74AHC32D,118
IC26: 74AHC74PW,118; SOP65P640X110-14N; Manufacturer_Part_Number 74AHC74PW,118
R11: 1K5; R_1206_3216Metric
SW4: SW_DIP_x05; DIP-10_W7.62mm
TP14, TP15: TestPoint; TestPoint_Pad_1.5x1.5mm
U2: SN74AHC1G08DBVR; SOT95P280X145-5N; Manufacturer_Part_Number SN74AHC1G08DBVR

Connections:
+5V: C24.2, C25.2, C27.2, C28.2, C29.2, IC5.5 (VCC), IC23.14 (VCC), IC24.14 (VCC), IC26.4 (1~SD), IC26.10 (2~SD), IC26.14 (VCC), U2.5 (VCC); also elsewhere on the board
/First toggle/CLK: IC5.6 (SELECT), IC23.2 (1B), IC23.4 (2A), IC24.4 (2A), IC24.9 (3A); also elsewhere on the board
/First toggle/FT: D6.2 (A), SW4.6, SW4.7, SW4.8, SW4.9, SW4.10; also elsewhere on the board
/First toggle/JANDK: IC23.1 (1A), IC26.1 (1~RD), IC26.2 (1D), IC26.12 (2D), IC26.13 (2~RD), SW4.1; also elsewhere on the board
/First toggle/NOTCLK: IC24.1 (1A); also elsewhere on the board
/First toggle/NOTJANDK: IC23.5 (2B); also elsewhere on the board
/First toggle/TDE: IC5.4 (A), SW4.3
/First toggle/TLATCHED: IC23.10 (3B), IC23.11 (4Y), IC24.10 (3B), SW4.2
/First toggle/TNE: IC5.1 (B1), IC24.2 (1B), IC26.9 (2Q), SW4.4
/First toggle/TPE: IC5.3 (B0), IC24.5 (2B), IC26.5 (1Q), SW4.5
/First toggle/X: IC24.8 (3Y), U2.2 (B)
GND: C24.1, C25.1, C27.1, C28.1, C29.1, IC5.2 (GND), IC23.7 (GND), IC24.7 (GND), IC24.12 (4A), IC24.13 (4B), IC26.7 (GND), R11.2, U2.3 (GND); also elsewhere on the board
unnamed: D6.1 (K), R11.1
unnamed: IC23.3 (1Y), IC23.13 (4B)
unnamed: IC23.6 (2Y), TP14.1, U2.1 (A)
unnamed: IC23.9 (3A), TP15.1, U2.4 (Y)
unnamed: IC23.8 (3Y), IC23.12 (4A)
unnamed: IC24.3 (1Y), IC26.11 (2CP)
unnamed: IC24.6 (2Y), IC26.3 (1CP)

Notes on the sheet:
NAND
D (PE) S PRESETEM A CLEAREM
AND
2:1 MUX
CLEAR D LATCHE POMOCÍ AND

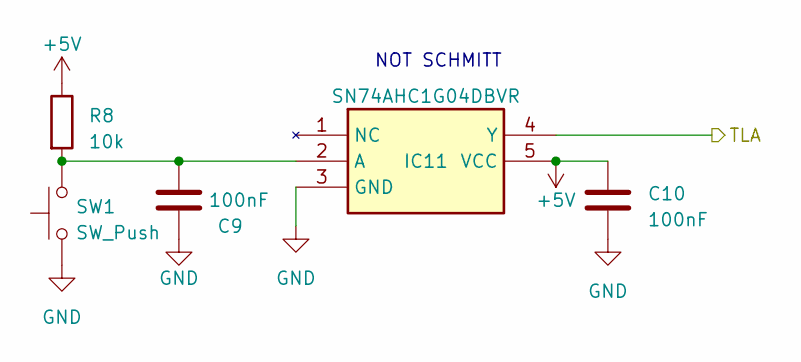
[picture p51: schematic tlacitko.kicad_sch]

Parts:
C9, C10: 100nF; C_1206_3216Metric
IC11: SN74AHC1G04DBVR; SOT95P280X145-5N; Manufacturer_Part_Number SN74AHC1G04DBVR
R8: 10k; R_1206_3216Metric
SW1: SW_Push; SW_PUSH_6mm_H7.3mm

Connections:
+5V: C10.2, IC11.5 (VCC), R8.1; also elsewhere on the board
/Vstupy/Tlačítko/TLA: IC11.4 (Y); also elsewhere on the board
GND: C9.1, C10.1, IC11.3 (GND), SW1.1; also elsewhere on the board
unnamed: C9.2, IC11.2 (A), R8.2, SW1.2

Parts of its further copies:
C11, C12, C13, C14: 100nF; C_1206_3216Metric
IC12, IC13: SN74AHC1G04DBVR; SOT95P280X145-5N; Manufacturer_Part_Number SN74AHC1G04DBVR
R9, R10: 10k; R_1206_3216Metric
SW2, SW3: SW_Push; SW_PUSH_6mm_H7.3mm

Connections of its further copies:
+5V: C12.2, C14.2, IC12.5 (VCC), IC13.5 (VCC), R9.1, R10.1; also elsewhere on the board
/Vstupy/Tlačítko1/TLA: IC12.4 (Y); also elsewhere on the board
/Vstupy/Tlačítko2/TLA: IC13.4 (Y); also elsewhere on the board
GND: C11.1, C12.1, C13.1, C14.1, IC12.3 (GND), IC13.3 (GND), SW2.1, SW3.1; also elsewhere on the board
unnamed: C11.2, IC12.2 (A), R9.2, SW2.2
unnamed: C13.2, IC13.2 (A), R10.2, SW3.2

Notes on the sheet:
NOT SCHMITT

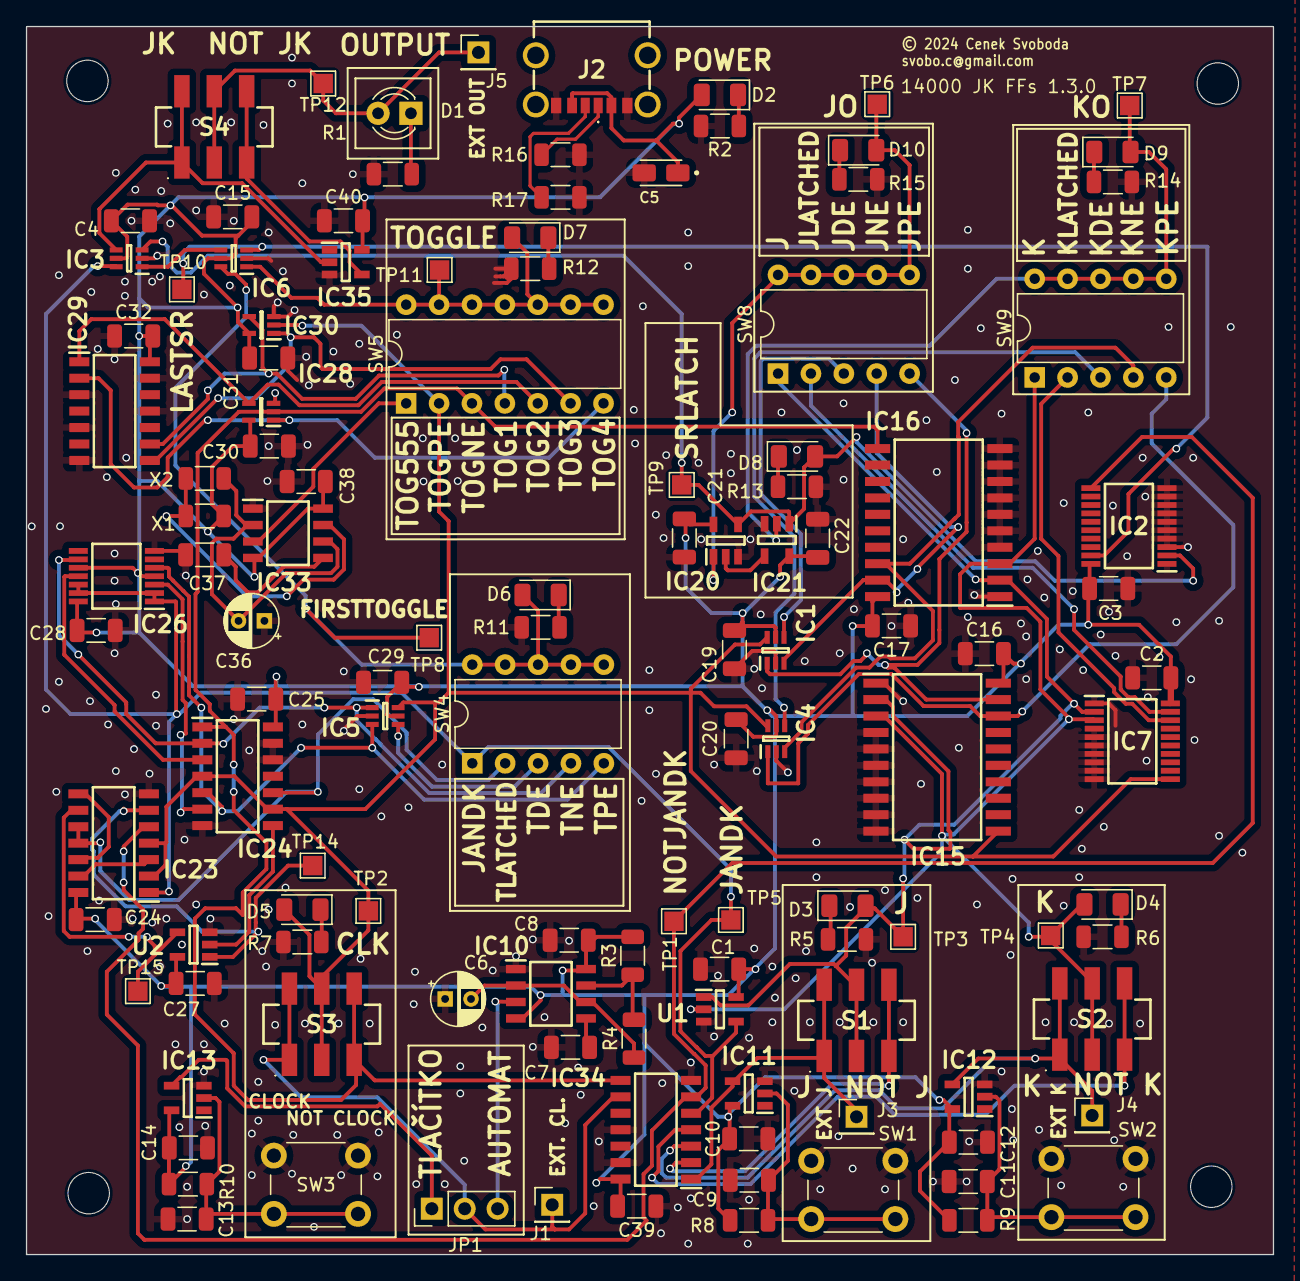
[picture p52: board 14000JKFF.kicad_pcb from above]

Board: 2 copper layers, 96.3 x 94.8 mm, 124 parts (0 on the bottom side), 71 nets.
