cenekSvoboda/14000JKFF/(commit log)

2024-04-18 14000JKFF 1.1.0
    [14000JKFF.kicad_pcb, 14000JKFF.kicad_sch, firstToggle.kicad_sch, klopeni_vstupu.kicad_sch, napajeni.kicad_sch, toggling.kicad_sch, vstupy.kicad_sch]
2024-05-08 version 1.3
    [14000JKFF.kicad_pcb, 14000JKFF.kicad_sch, SRLatch.kicad_sch, firstToggle.kicad_sch, klopeni_vstupu.kicad_sch, napajeni.kicad_sch, tlacitko.kicad_sch, toggling.kicad_sch]
