cenekSvoboda/14000JKFF/(notices)

Notices in the files:
14000JKFF.kicad_pcb:
© 2024 Cenek Svoboda
